Bkorotko03/ALTrainSeismo/ALProjNotes/AL ToDo.md

#### Generic
This is a todo list for the project. Please leave initials and such for completion or requests.
- [ ] get access to underneath redline SOON
- [x] order parts
- [x] Design the actual geophone, make sure the spec is good enough we can do 3 of them
- [ ] ~~figure out math for magnet movement vs coil voltage~~
- [ ] finalize code for signal processing on raspi
- [x] figure out how to take in analog voltage on arduino and output to sd card
- [ ] update parts list
- [ ] set concrete timelines
- [ ] oh yeah we should make our docs better and have code comments

### Making the geophones
- [ ] makes holes in the jars
- [ ] figure out how we're mounting these, level surfaces?
- [ ] mount spring and magnets on rods
- [ ] make coils
- [ ] figure out amplification!!

### arduinos
- [ ] how exactly are we attaching the coils to the arduino? pins are soldered oops
- [ ] best data conventions to make backend easy?
- [ ] how much preprocess can we afford to do on arduino?

### backend
- [ ] feasible to run on pi? do test run of no signal to see how heavy computation is
- [ ] write code to go from csv - panda - np arrays so we can make PSD estimate
- [ ] write code for figures
- [ ] make into interactive python script in terminal, want notebooks for dev only probably

#### Bennett

#### Cole

#### Danny

#### Jill
