Bkorotko03/ALTrainSeismo/ALProjNotes/DailyNotes.md

### 2/10/26
- Start development offline
- Can move to RF later if we feel like it
- We're going to try and make geophones, see link [here](https://www.embedded.com/geophone-with-arduino-r4/)
- Sent a basic parts list today to Bougie

### 4/2/26
- Glue op amps and arduino cases onto the jars
- Perform test run near red line
- Send email to transit
- Make PSD of mag run
- do a nomag run
- Make PSD of nomag run
