Bkorotko03/ALTrainSeismo/figureOut/260413_220258/avgEventPSDfs50.0.png

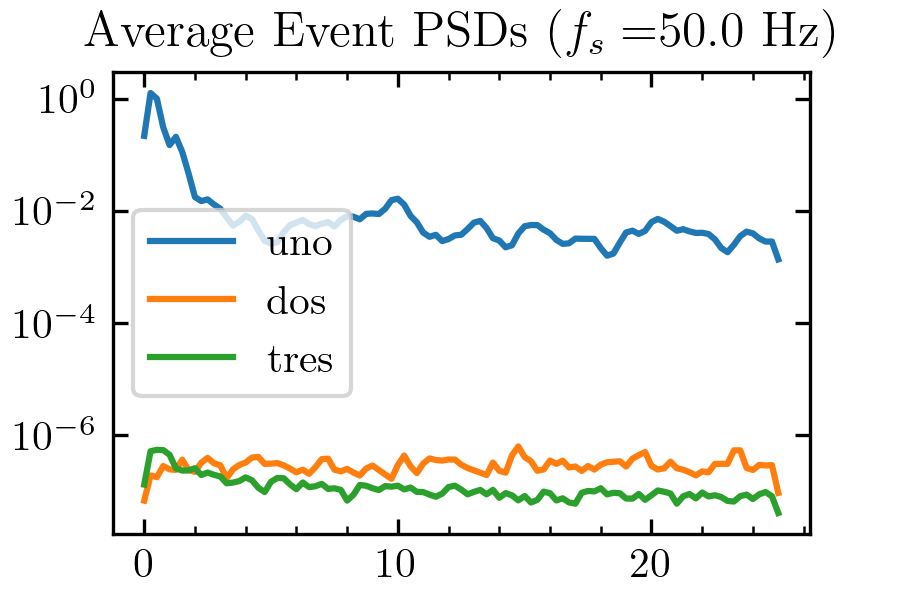
figureOut/260413_220258/avgEventPSDfs50.0.png
