Bkorotko03/ALTrainSeismo/figureOut/260413_221004/ampNoise.png

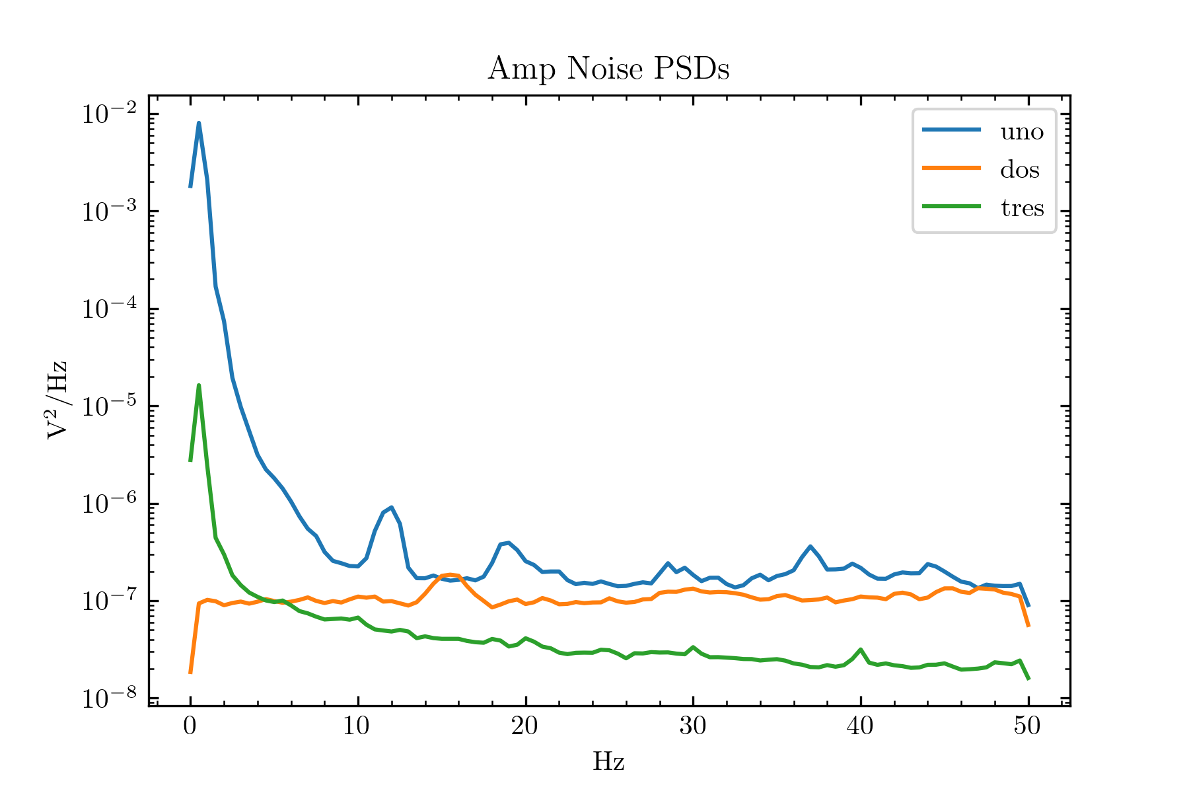
figureOut/260413_221004/ampNoise.png
