Bkorotko03/ALTrainSeismo/figureOut/260413_221004/avgEventPSDfs100.png

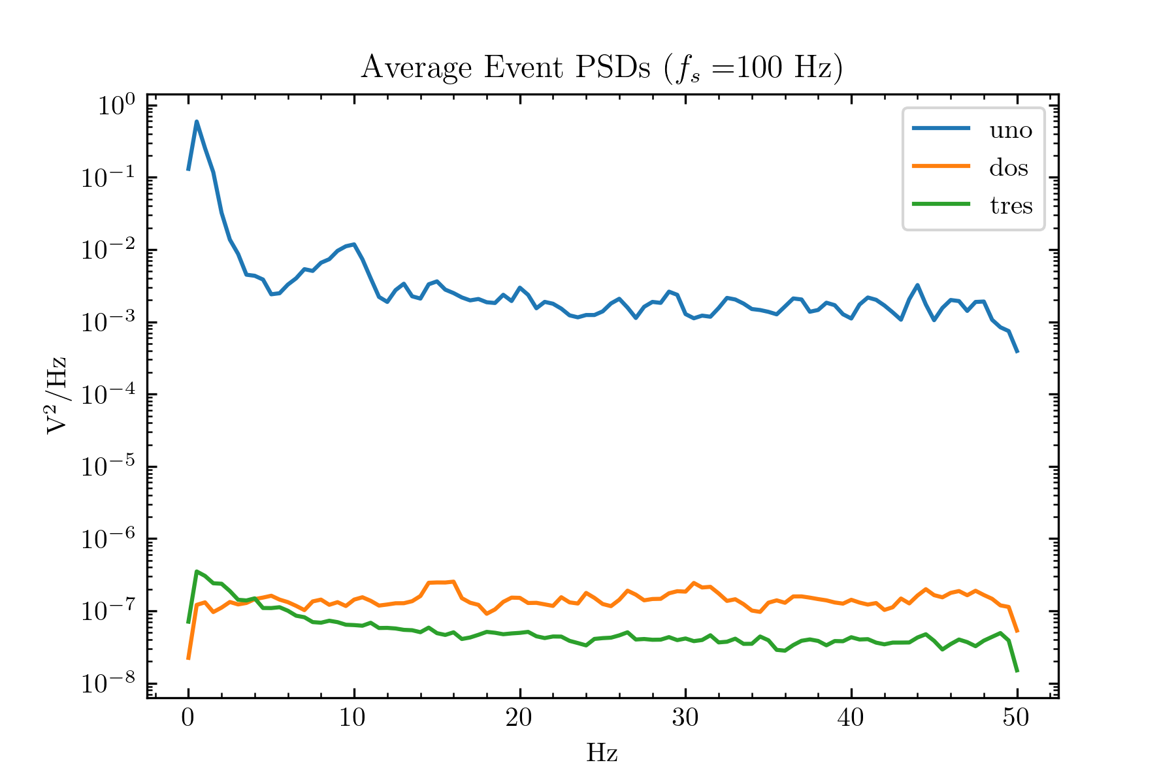
figureOut/260413_221004/avgEventPSDfs100.png
