Bkorotko03/ALTrainSeismo/figureOut/260413_221004/bkgdOverAmp.png

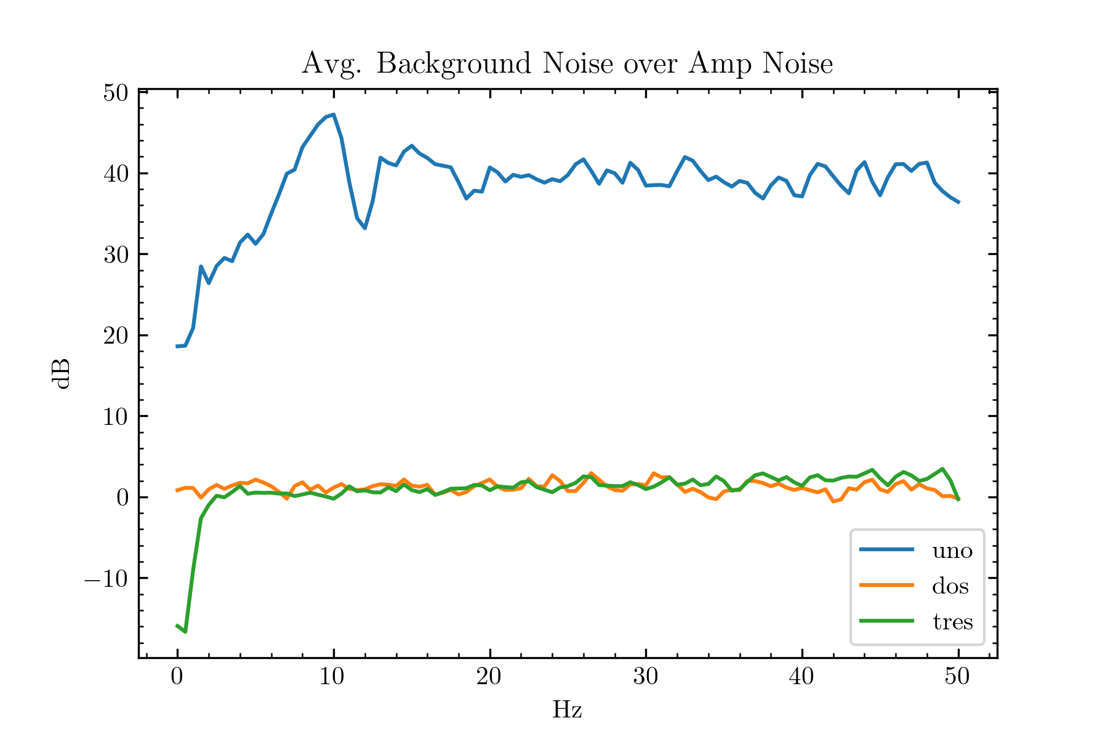
figureOut/260413_221004/bkgdOverAmp.png
