Bkorotko03/ALTrainSeismo/figureOut/260413_221004/dosEventVolt.png

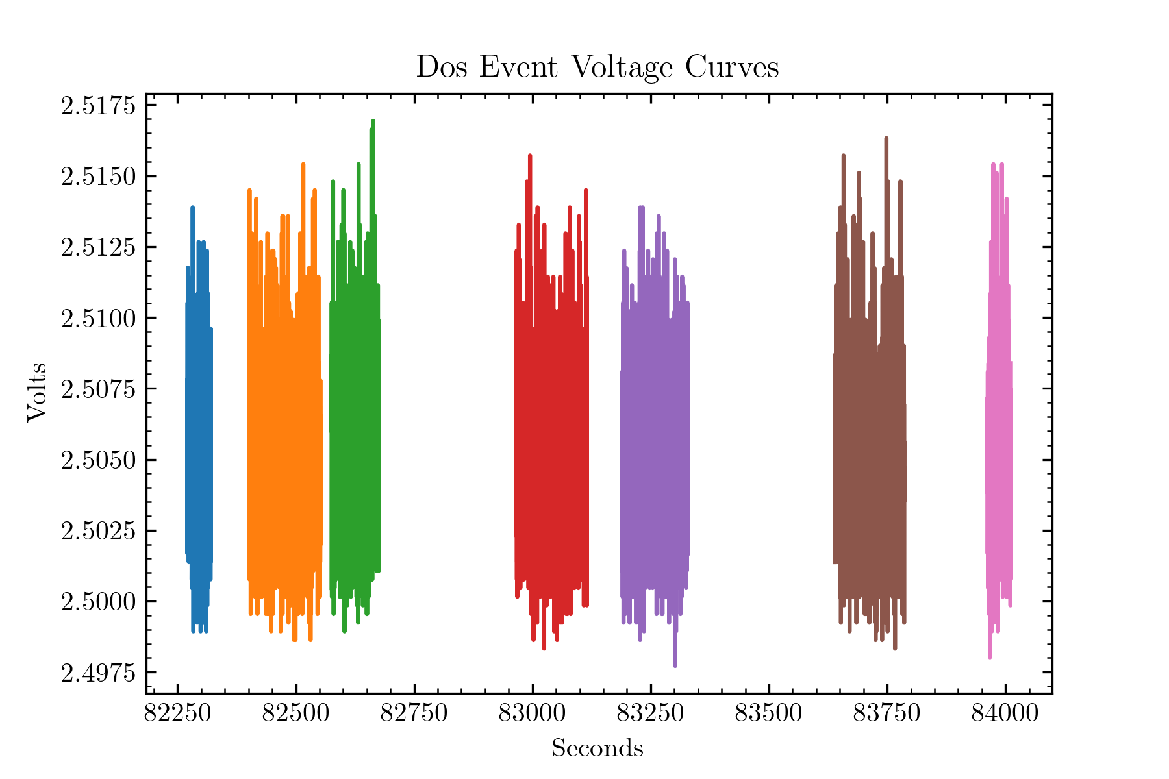
figureOut/260413_221004/dosEventVolt.png
