Bkorotko03/ALTrainSeismo/figureOut/260413_221004/dosNoiseVolt.png

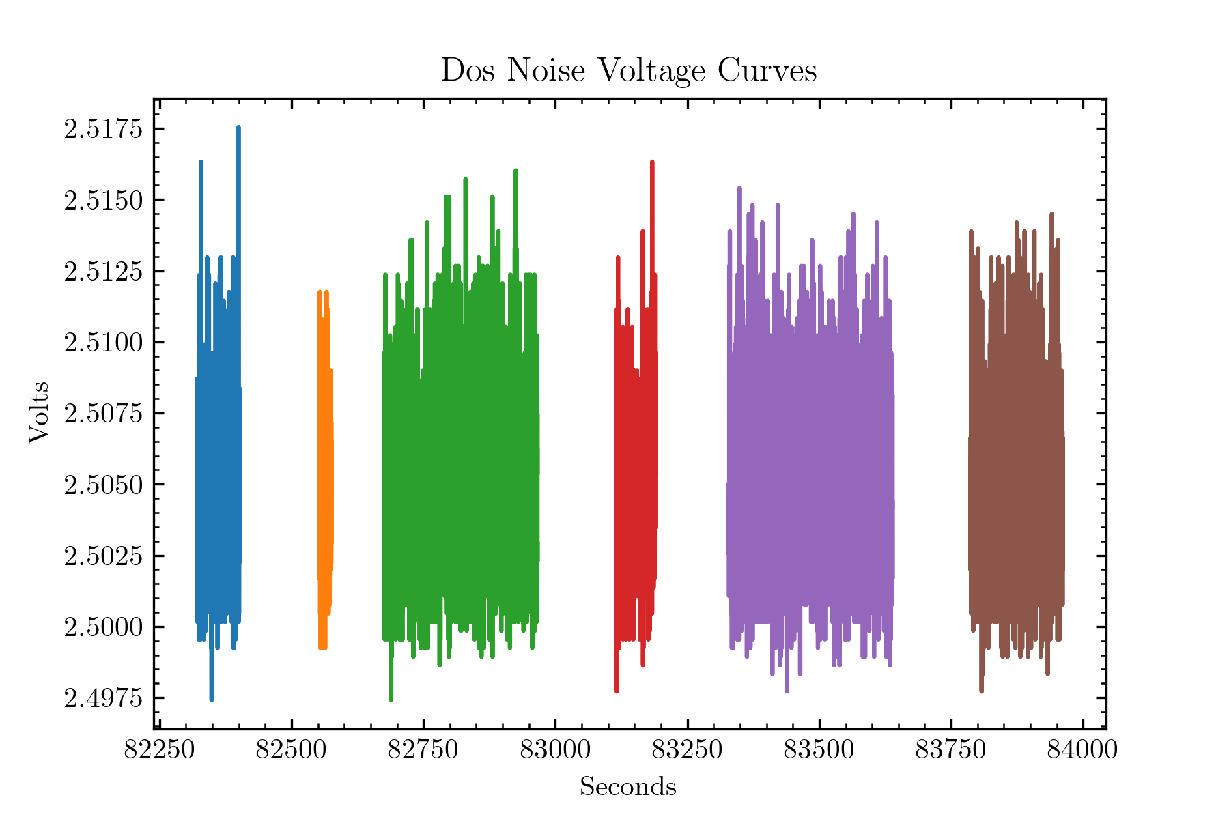
figureOut/260413_221004/dosNoiseVolt.png
