Bkorotko03/ALTrainSeismo/figureOut/260413_221004/rawSignal.png

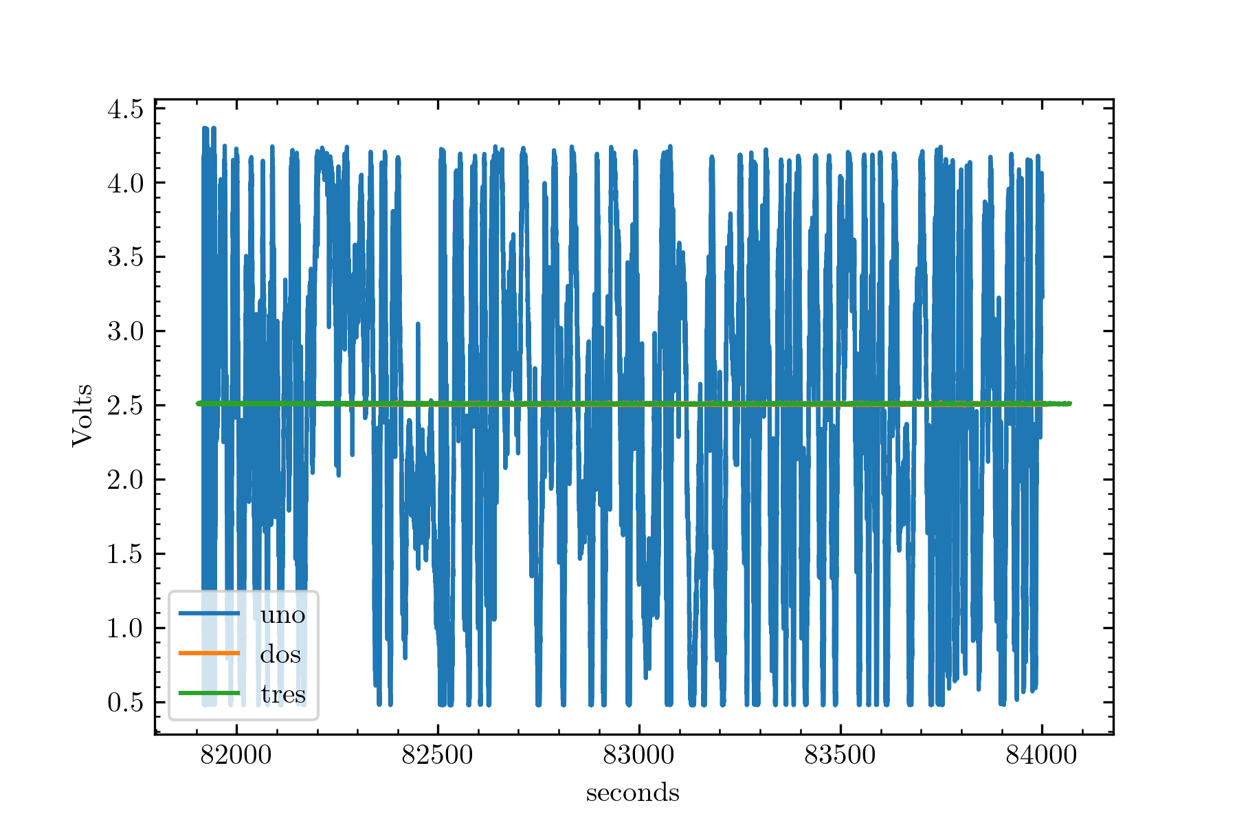
figureOut/260413_221004/rawSignal.png
