Bkorotko03/ALTrainSeismo/figureOut/260413_221004/trainOverBkgd.png

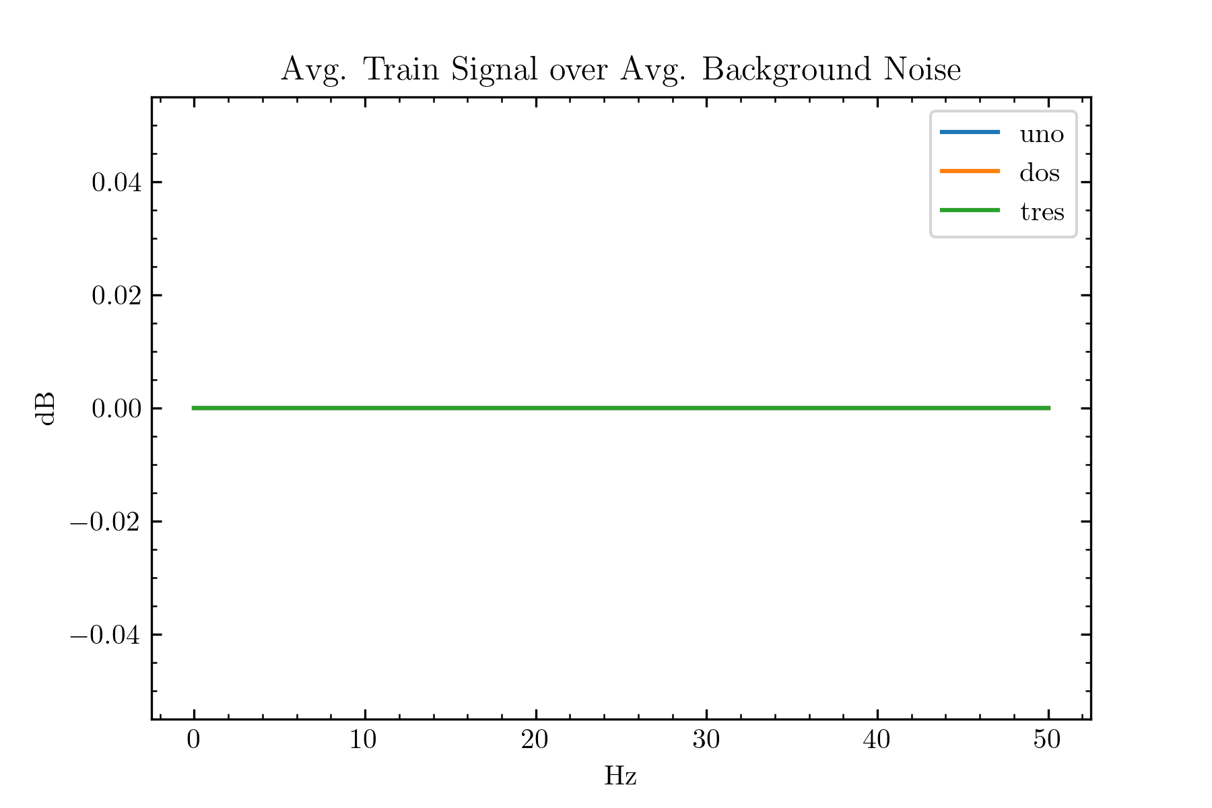
figureOut/260413_221004/trainOverBkgd.png
