Bkorotko03/ALTrainSeismo/figureOut/260413_221004/tresEventVolt.png

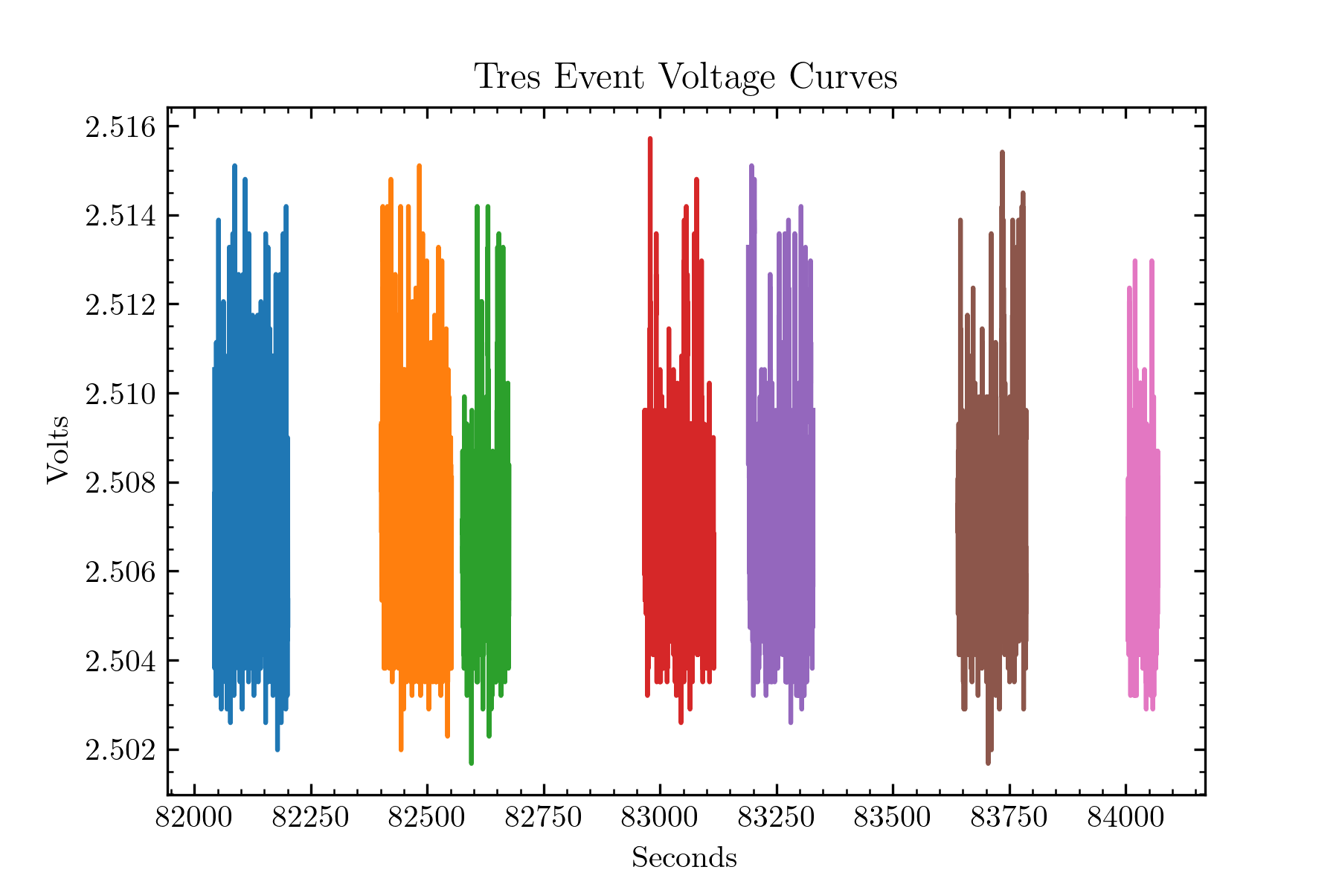
figureOut/260413_221004/tresEventVolt.png
