Bkorotko03/ALTrainSeismo/figureOut/260413_221004/tresNoiseVolt.png

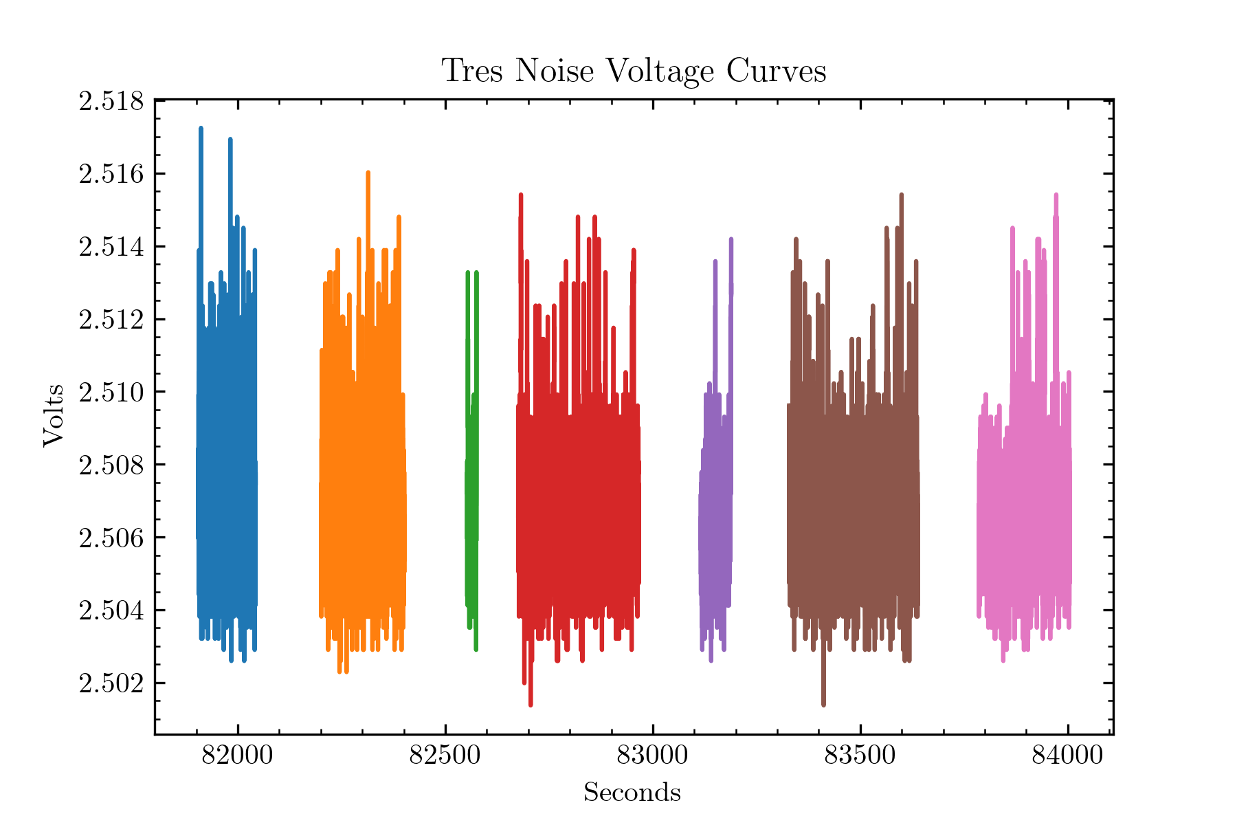
figureOut/260413_221004/tresNoiseVolt.png
