Bkorotko03/ALTrainSeismo/figureOut/260413_221004/unoEventVolt.png

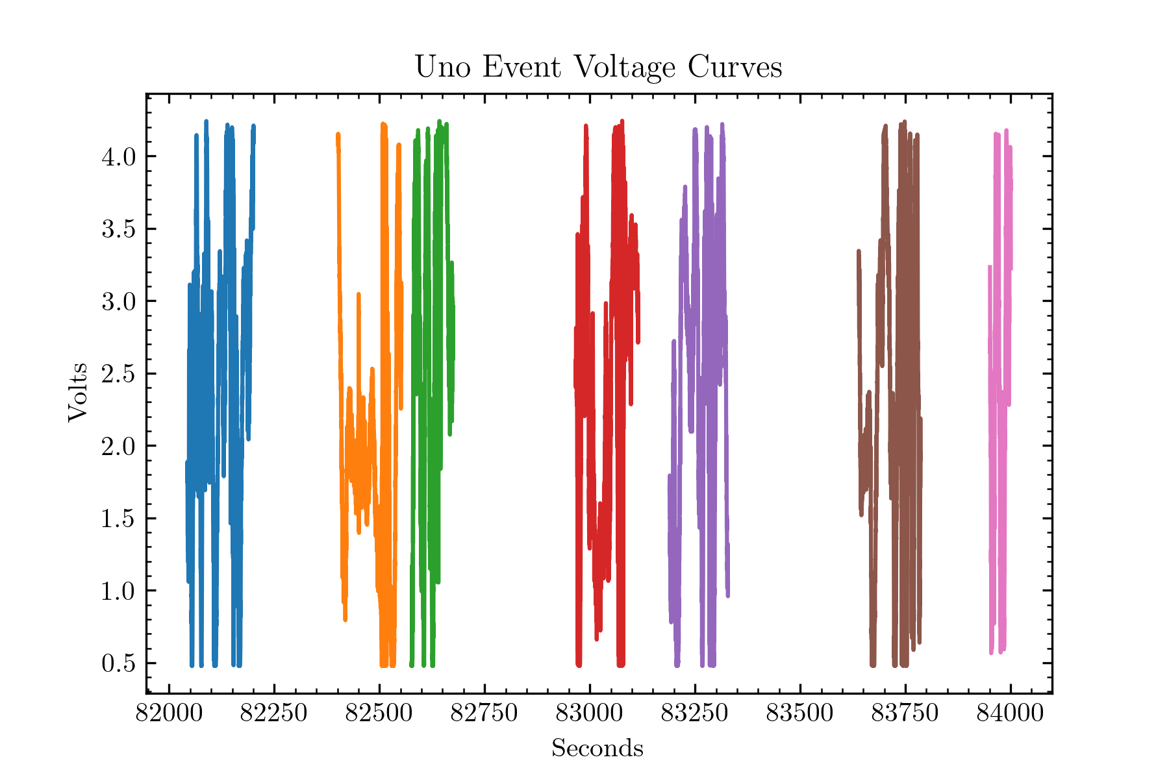
figureOut/260413_221004/unoEventVolt.png
