Bkorotko03/ALTrainSeismo/figureOut/260413_221004/unoNoiseVolt.png

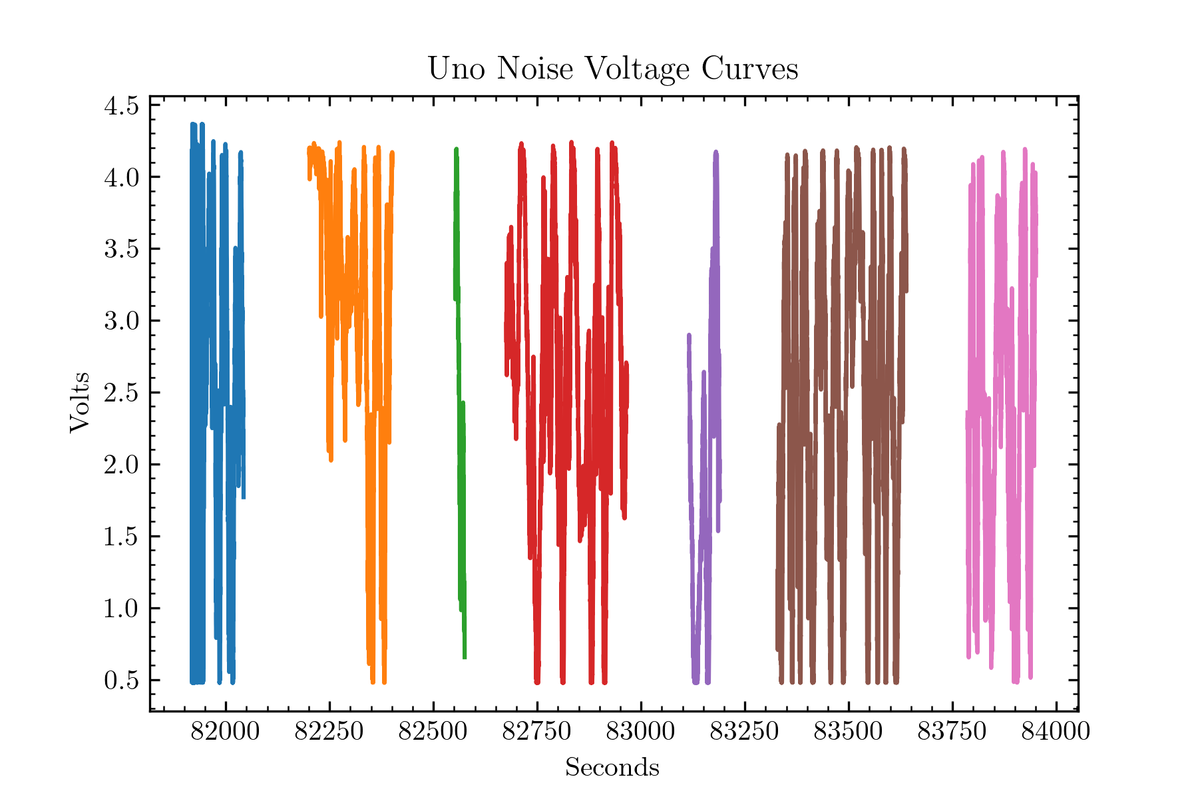
figureOut/260413_221004/unoNoiseVolt.png
