Bkorotko03/ALTrainSeismo/figureOut/260418_205335/ampNoisefs100.png

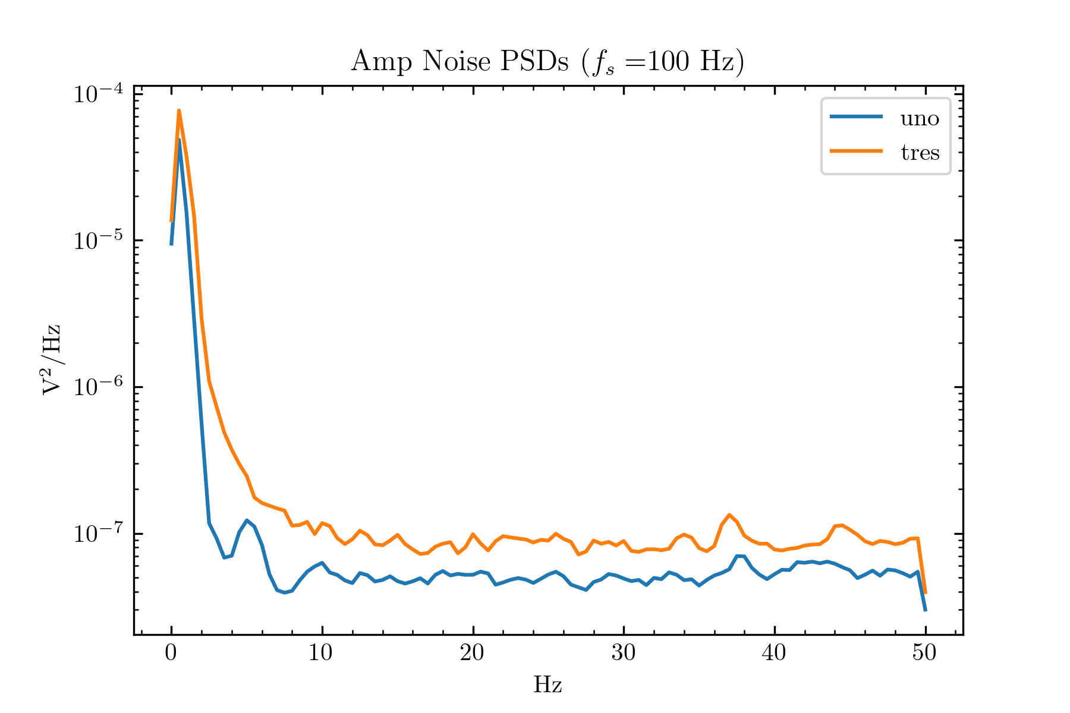
figureOut/260418_205335/ampNoisefs100.png
