Bkorotko03/ALTrainSeismo/figureOut/260418_205335/avgEventPSDfs100.png

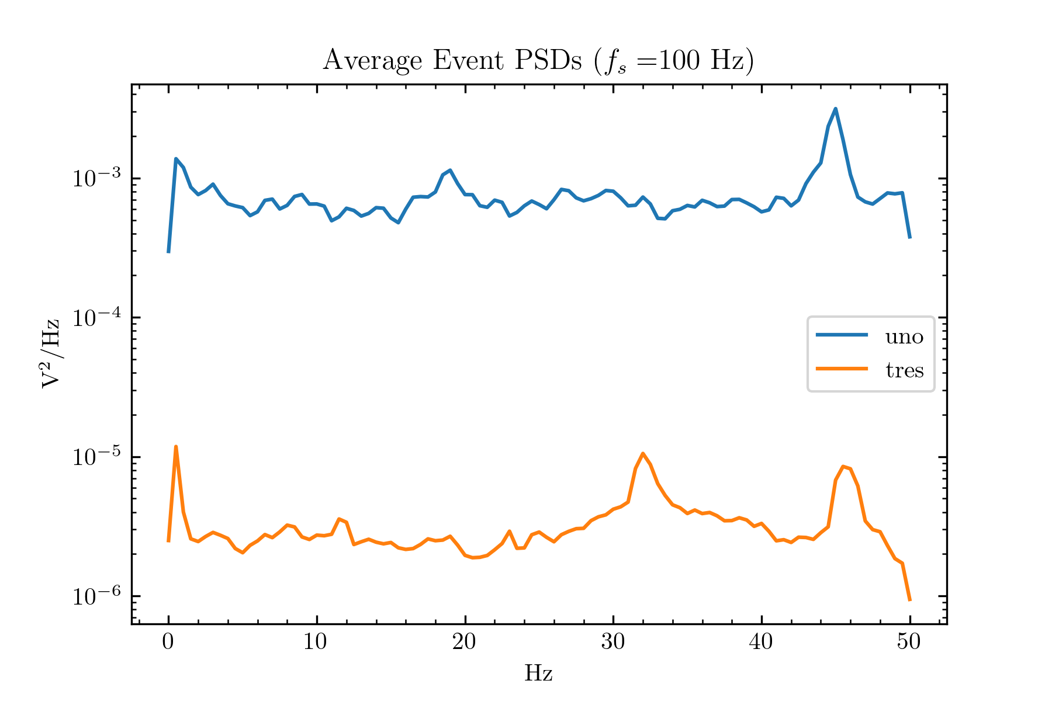
figureOut/260418_205335/avgEventPSDfs100.png
