Bkorotko03/ALTrainSeismo/figureOut/260418_205335/avgNoisePSDfs100.png

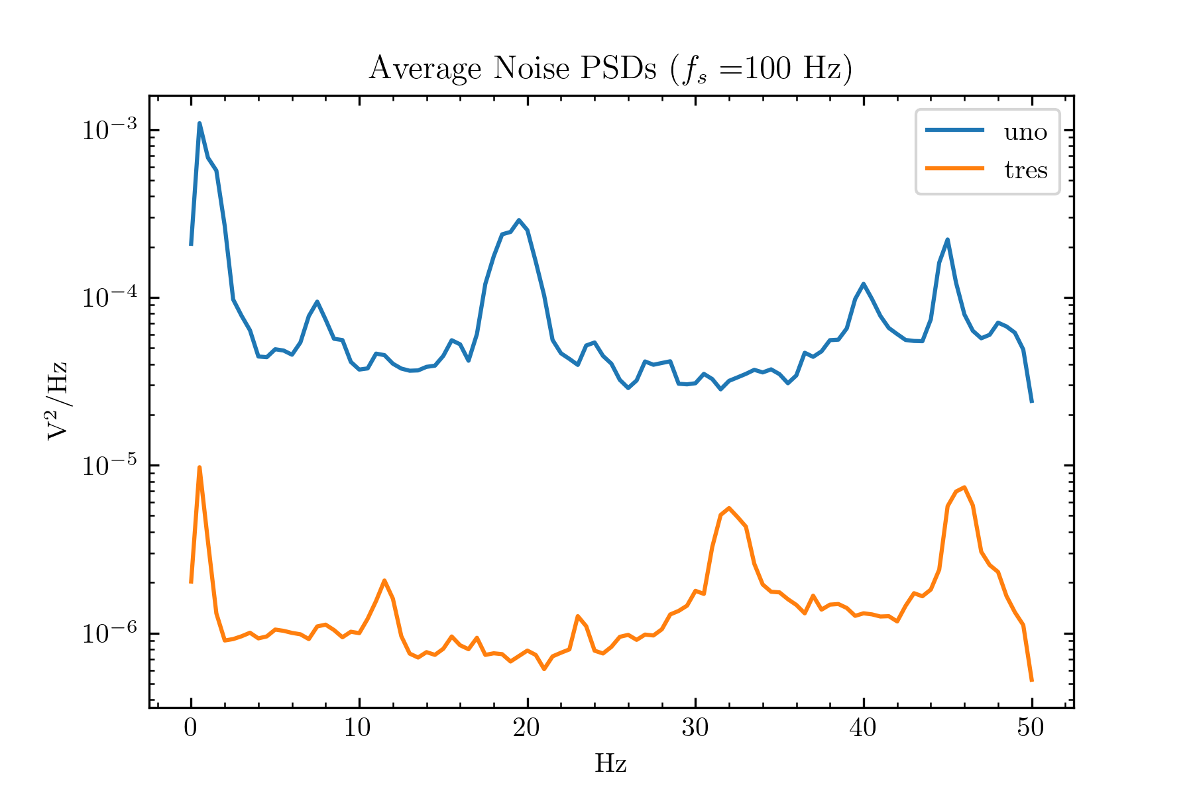
figureOut/260418_205335/avgNoisePSDfs100.png
