Bkorotko03/ALTrainSeismo/figureOut/260418_205335/bkgdOverAmpfs100.png

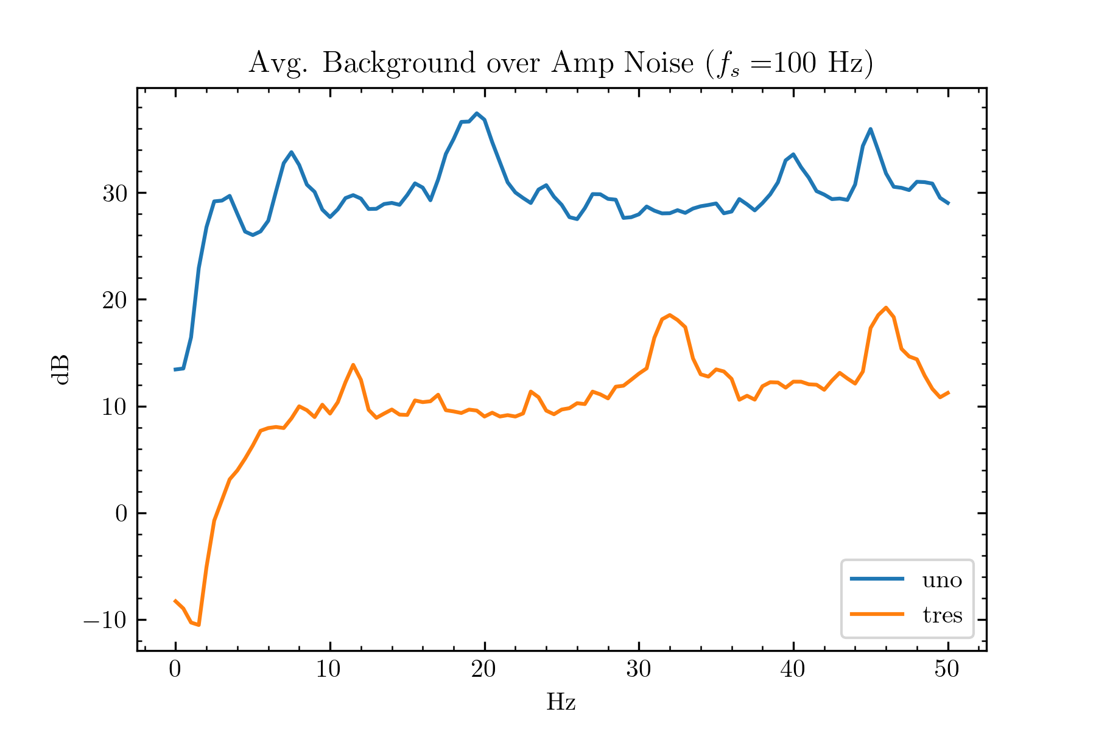
figureOut/260418_205335/bkgdOverAmpfs100.png
