Bkorotko03/ALTrainSeismo/figureOut/260418_205335/rawSignal.png

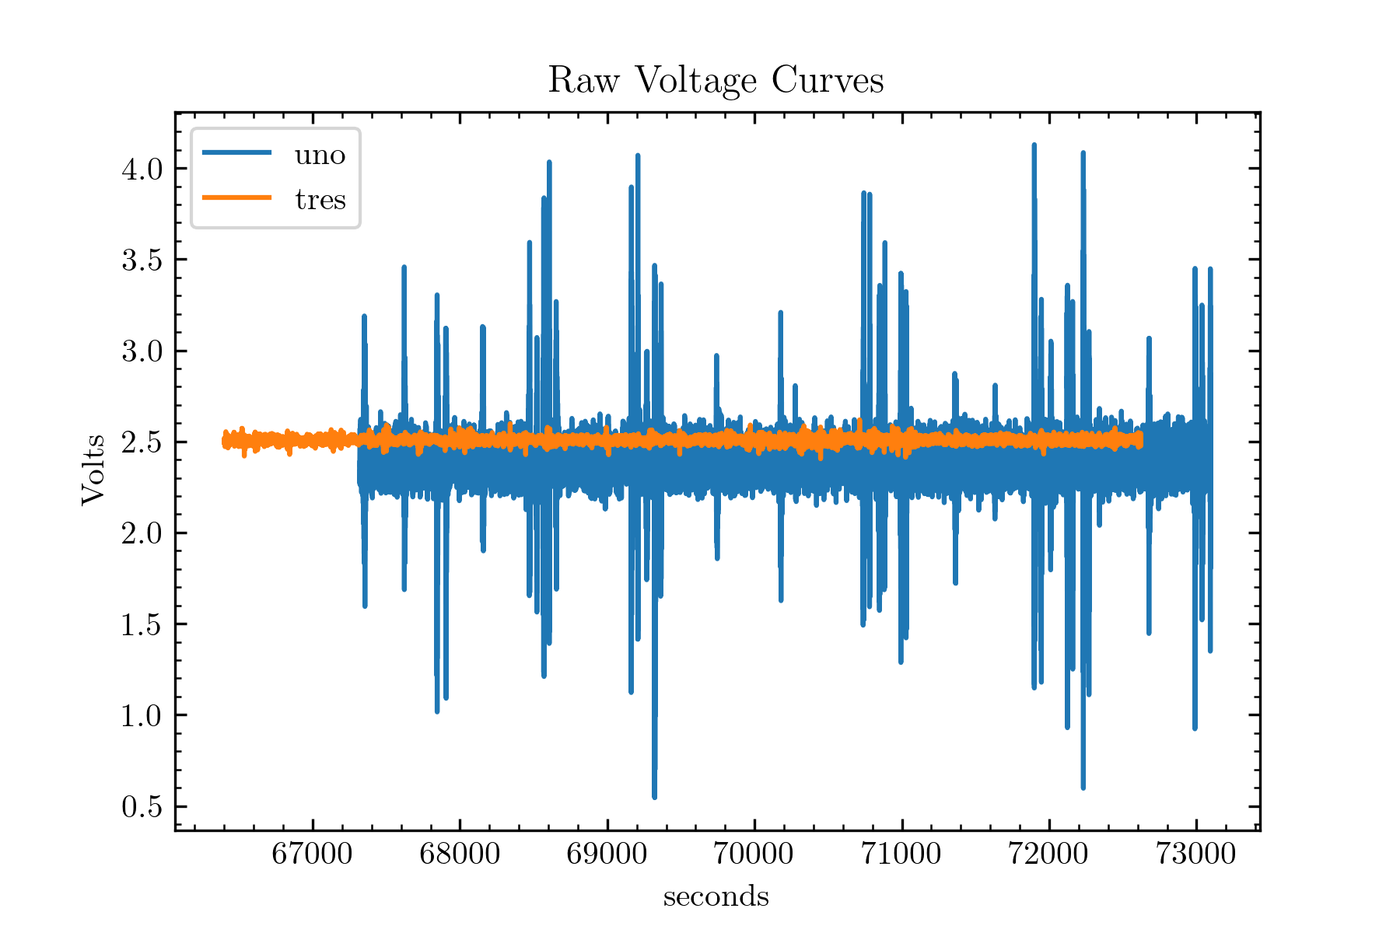
figureOut/260418_205335/rawSignal.png
