Bkorotko03/ALTrainSeismo/figureOut/260418_205335/SNRvsWindow.png

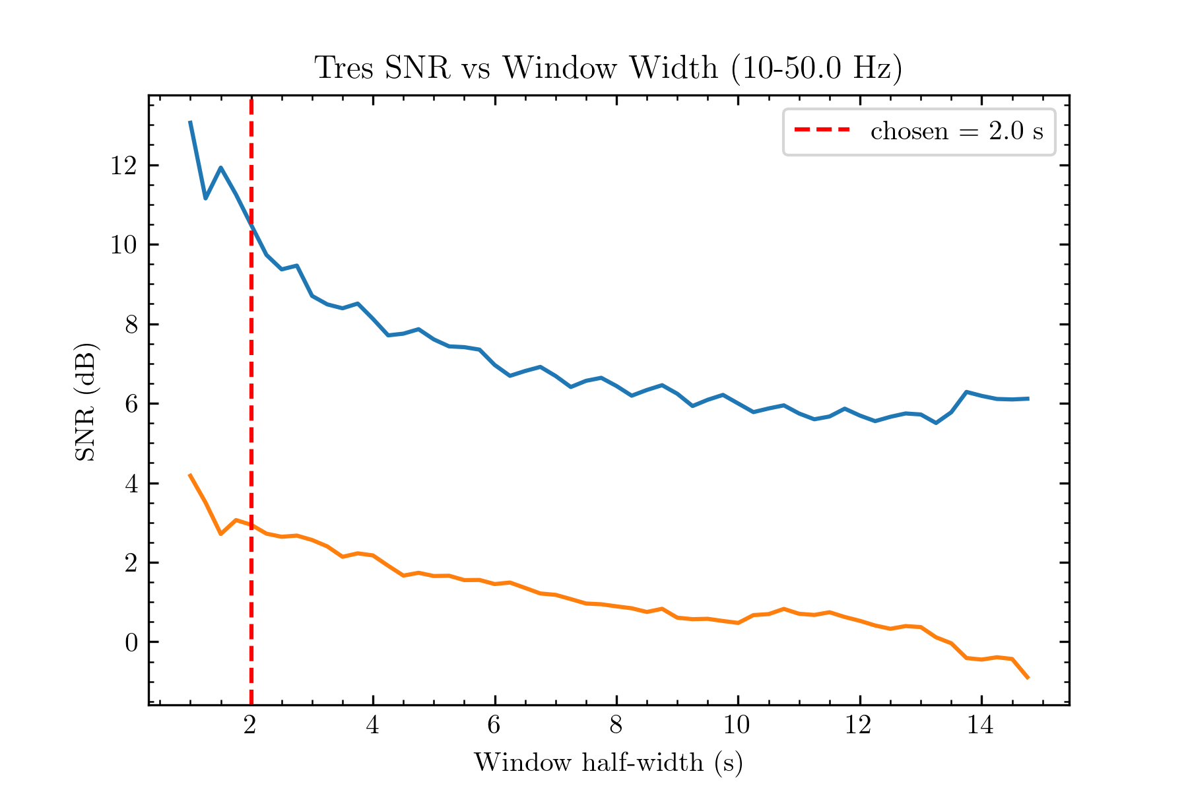
figureOut/260418_205335/SNRvsWindow.png
