Bkorotko03/ALTrainSeismo/figureOut/260418_205335/tresEventVolt.png

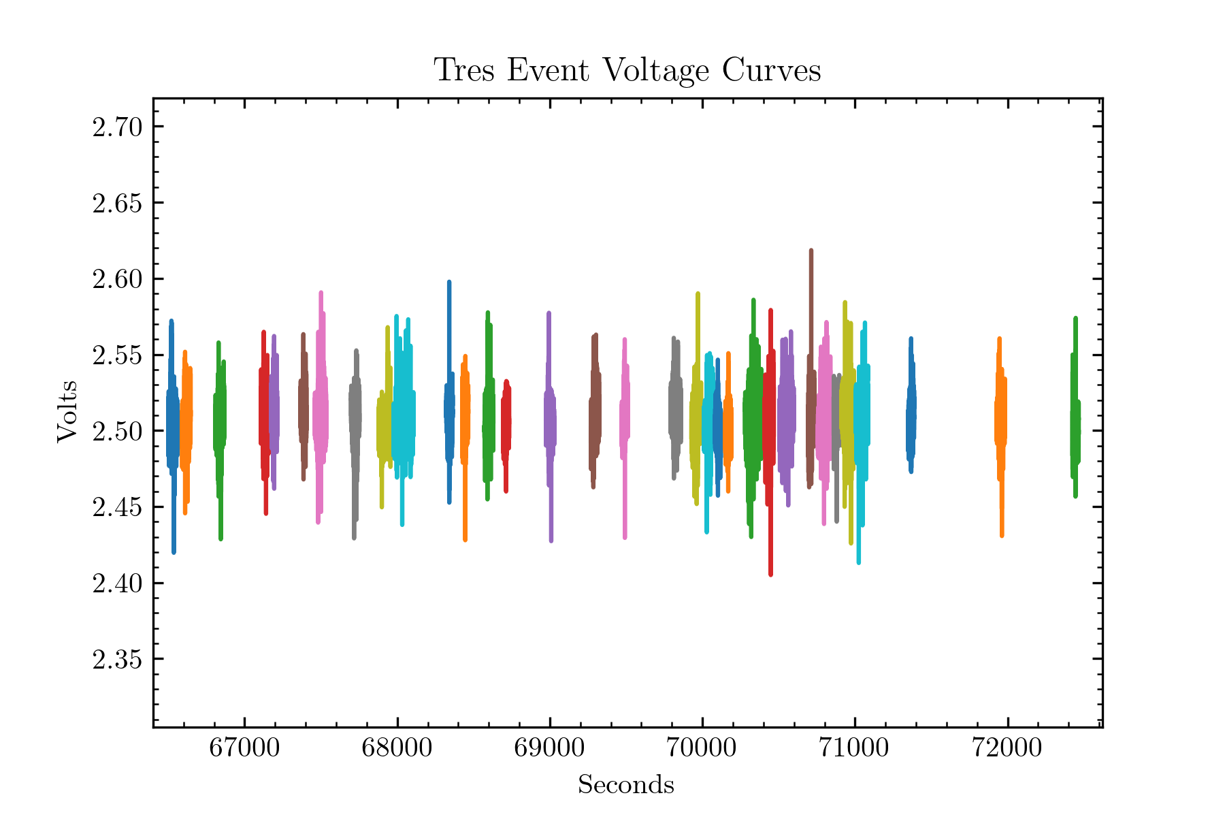
figureOut/260418_205335/tresEventVolt.png
