Bkorotko03/ALTrainSeismo/figureOut/260418_205335/tresNoiseVolt.png

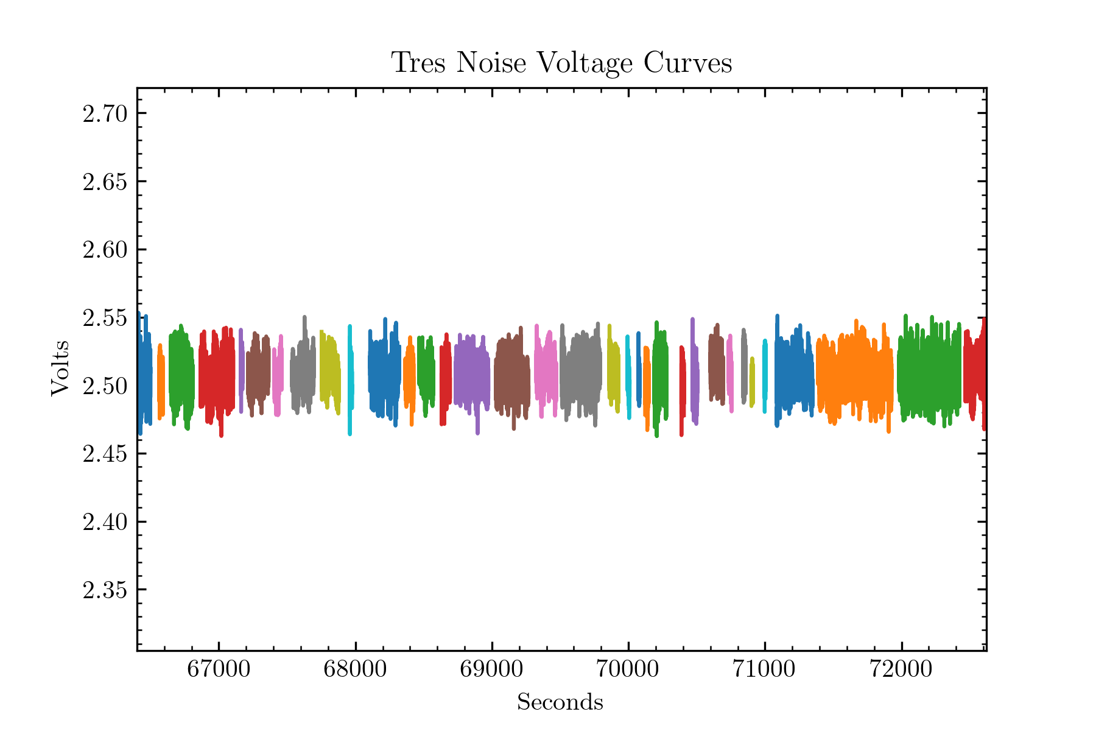
figureOut/260418_205335/tresNoiseVolt.png
