Bkorotko03/ALTrainSeismo/figureOut/260418_205335/unoEventVolt.png

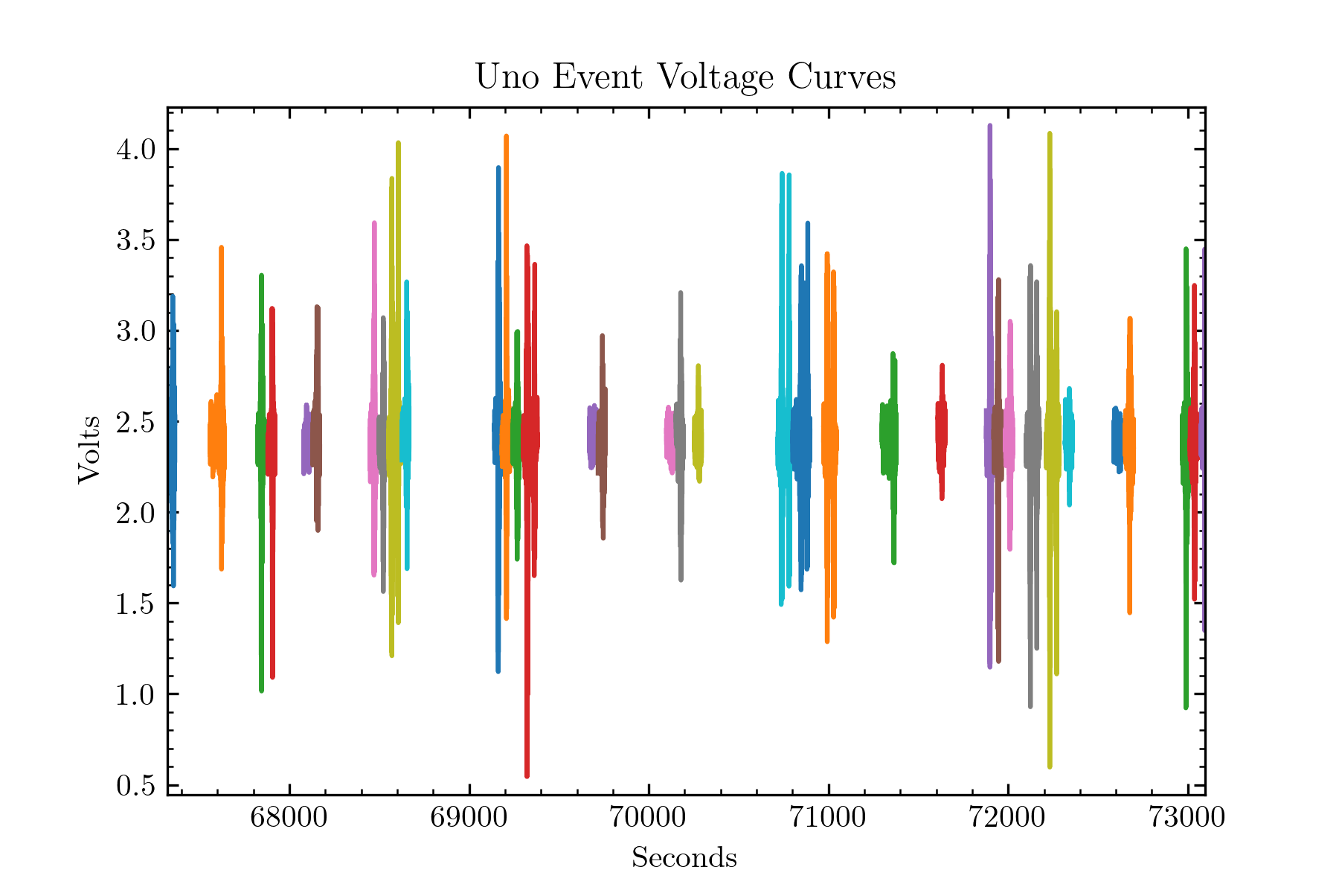
figureOut/260418_205335/unoEventVolt.png
