Bkorotko03/ALTrainSeismo/figureOut/260418_205335/unoNoiseVolt.png

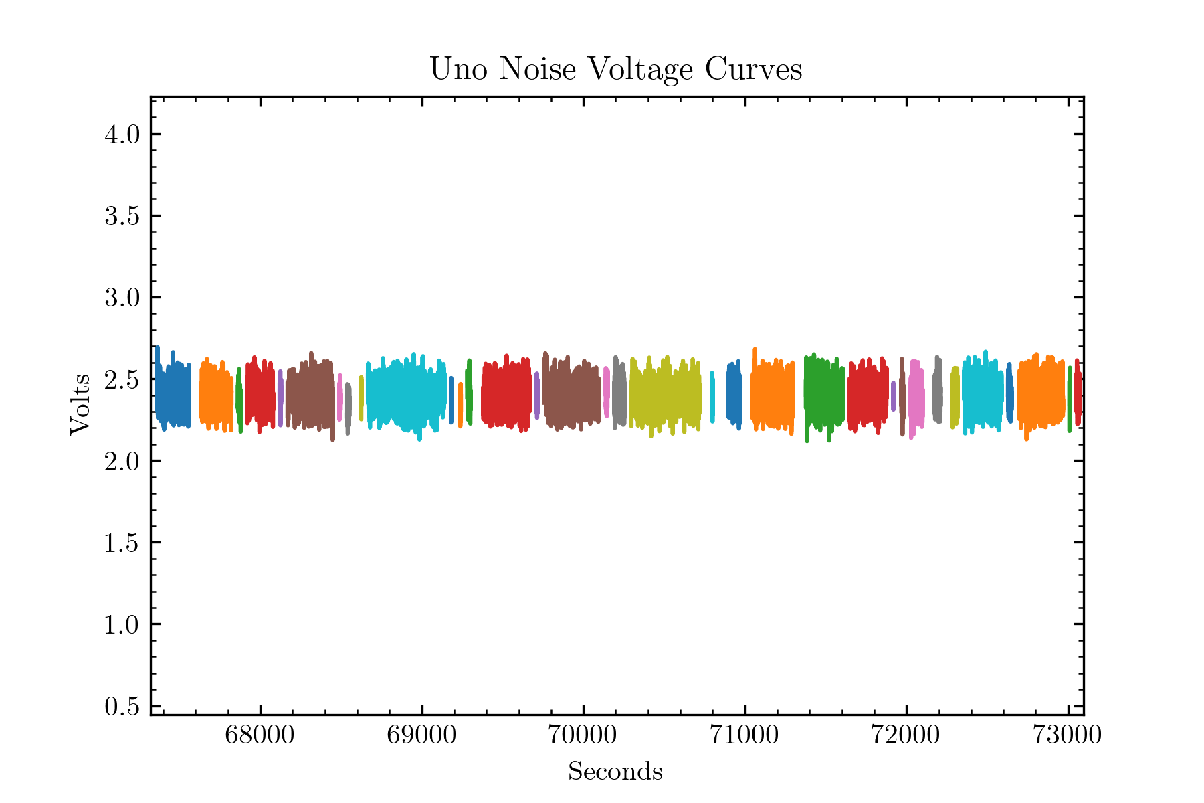
figureOut/260418_205335/unoNoiseVolt.png
