Bkorotko03/ALTrainSeismo/figureOut/conc3StatWork/tresSNRvsWindow.png

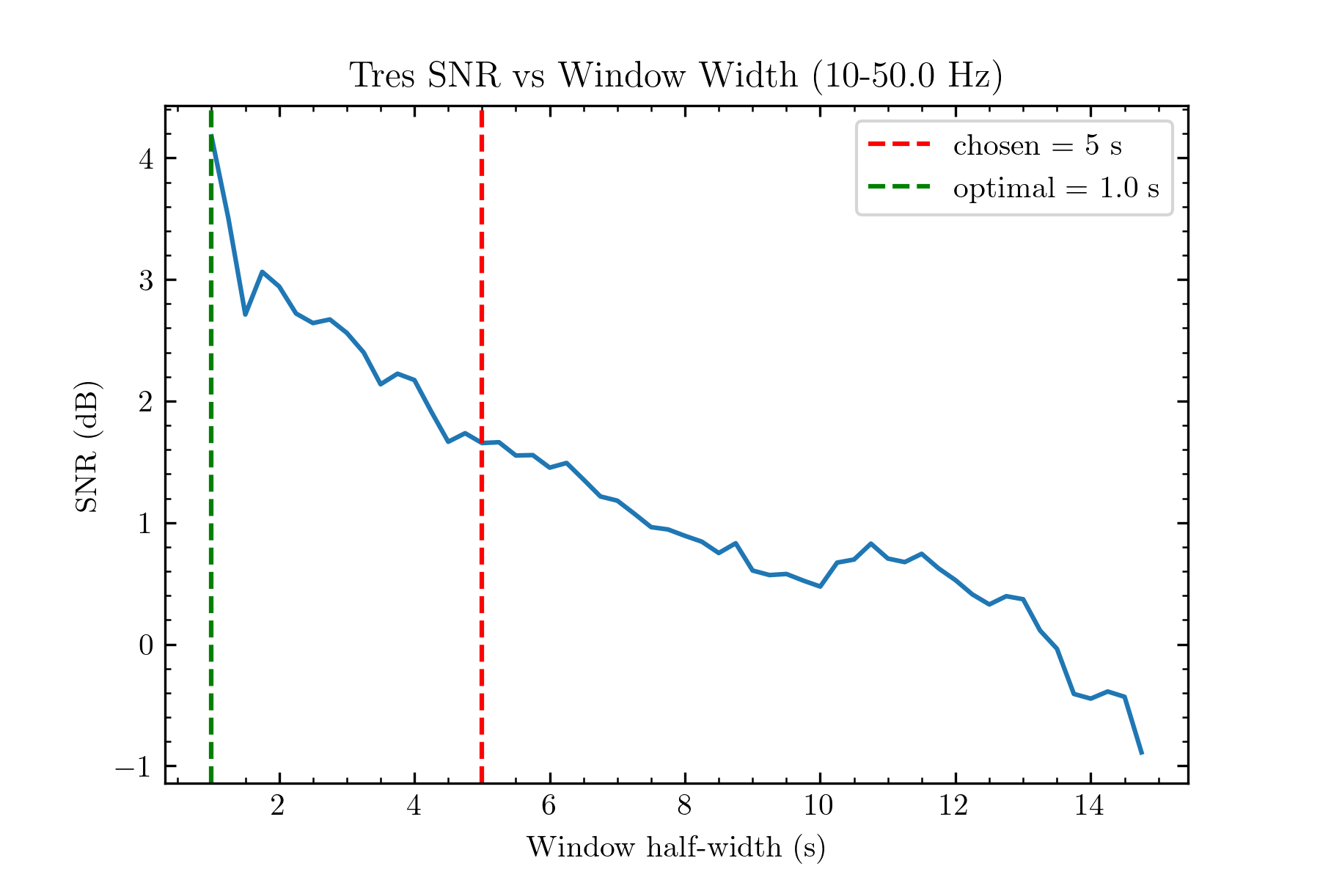
figureOut/conc3StatWork/tresSNRvsWindow.png
