Bkorotko03/ALTrainSeismo/figureOut/conc3StatWork/unoSNRvsWindow.png

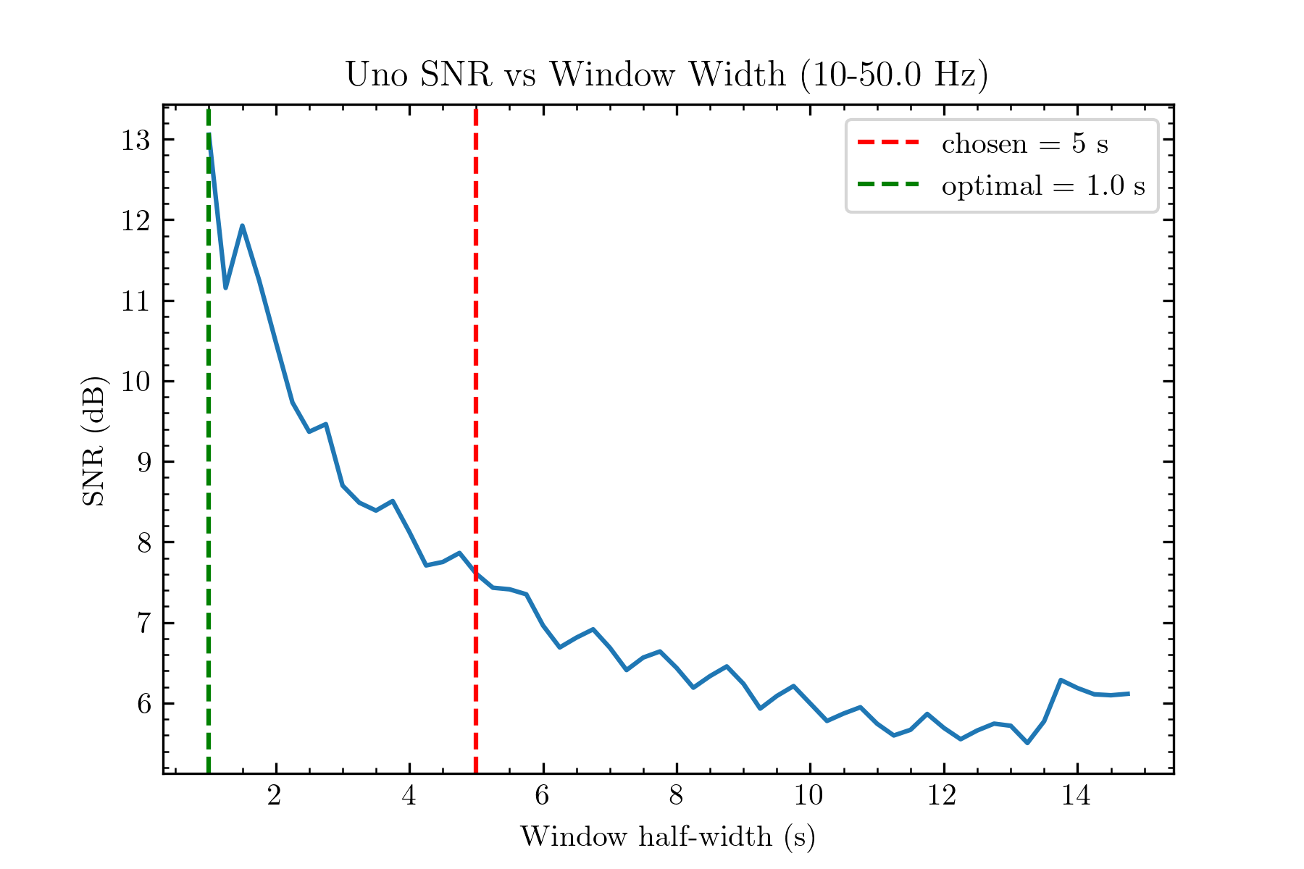
figureOut/conc3StatWork/unoSNRvsWindow.png
