Bkorotko03/ALTrainSeismo/figureOut/figFixed/avgEventPSDfs100.png

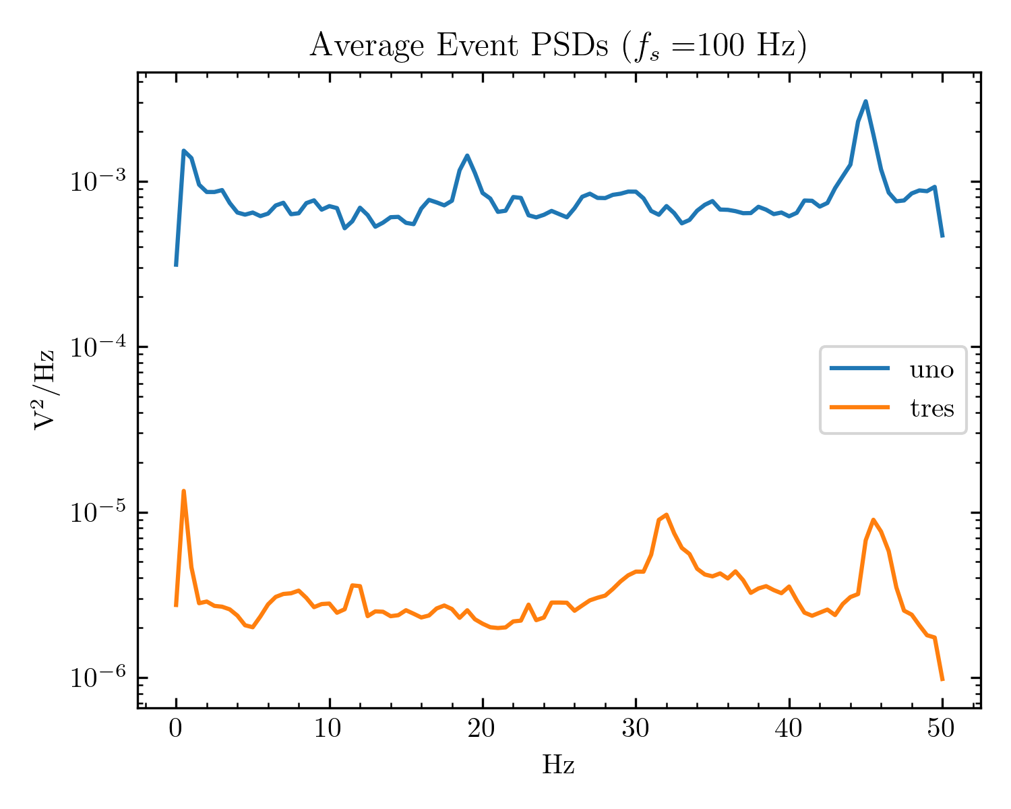
figureOut/figFixed/avgEventPSDfs100.png
