Bkorotko03/ALTrainSeismo/figureOut/figFixed/avgNoisePSDfs100.png

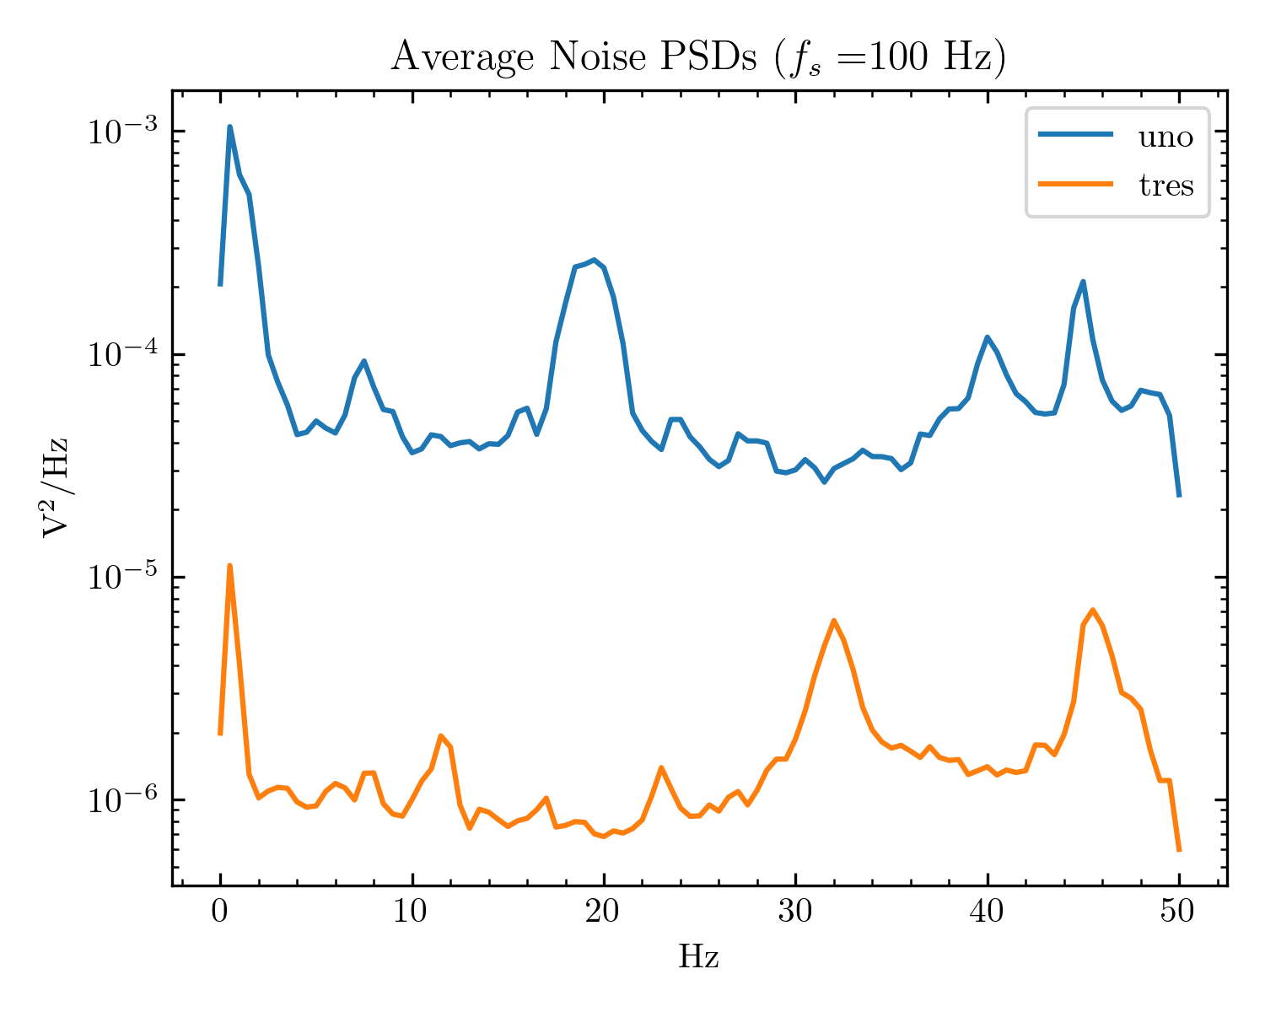
figureOut/figFixed/avgNoisePSDfs100.png
