Bkorotko03/ALTrainSeismo/figureOut/figFixed/bkgdOverAmpfs100.png

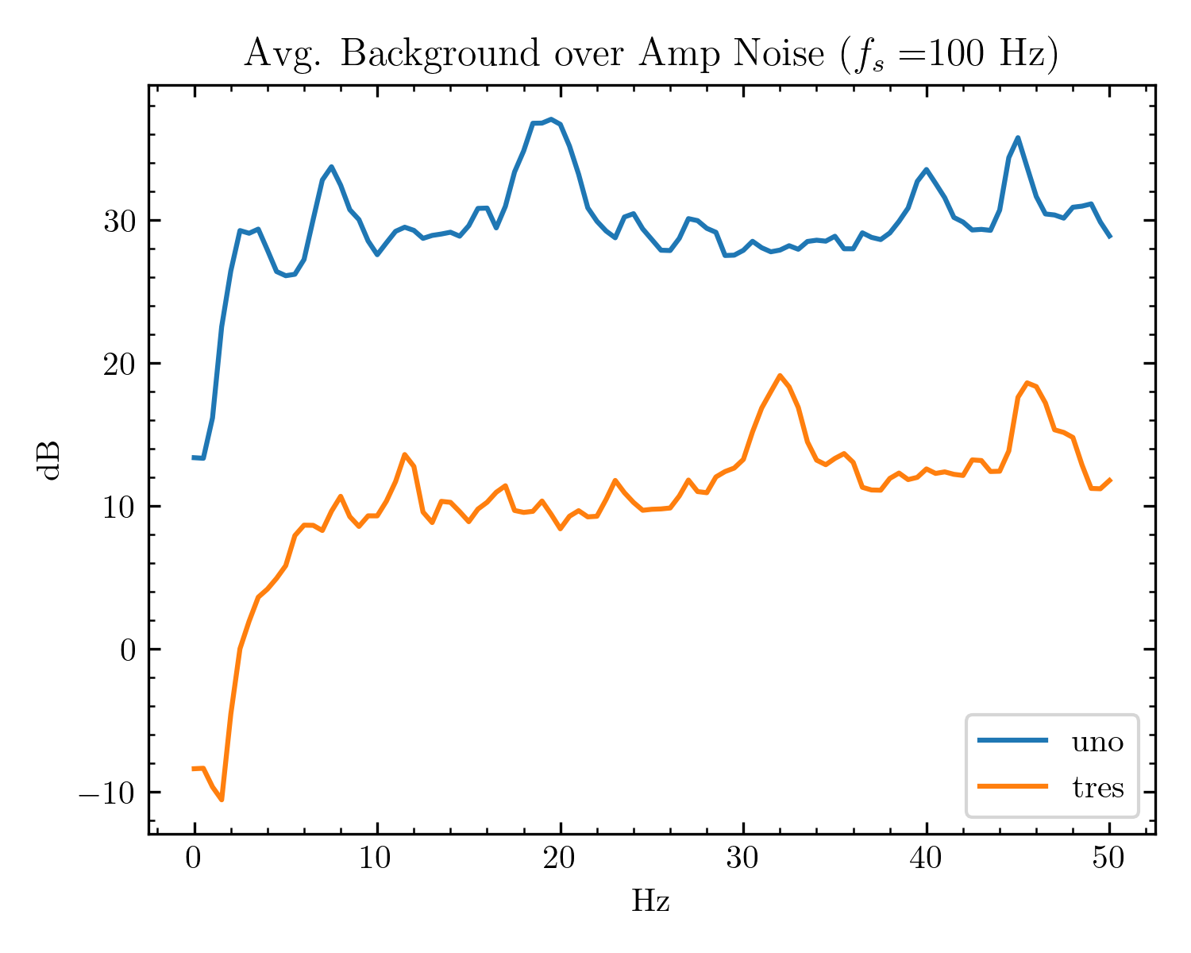
figureOut/figFixed/bkgdOverAmpfs100.png
