Bkorotko03/ALTrainSeismo/figureOut/figFixed/rawSignal.png

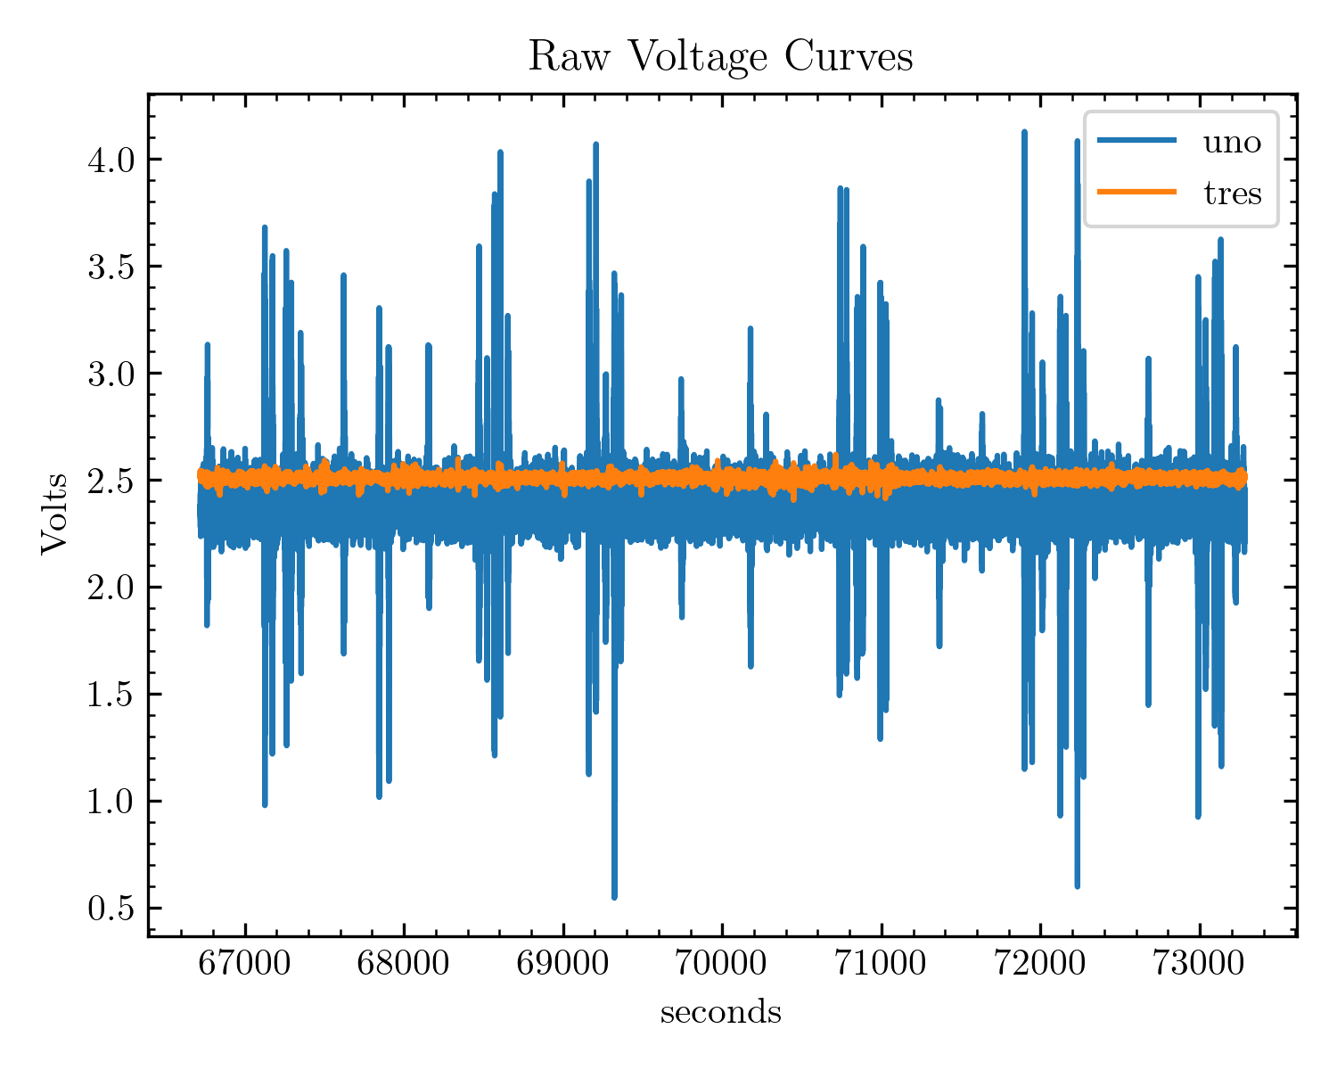
figureOut/figFixed/rawSignal.png
