Bkorotko03/ALTrainSeismo/figureOut/figFixed/SNRvsWindow.png

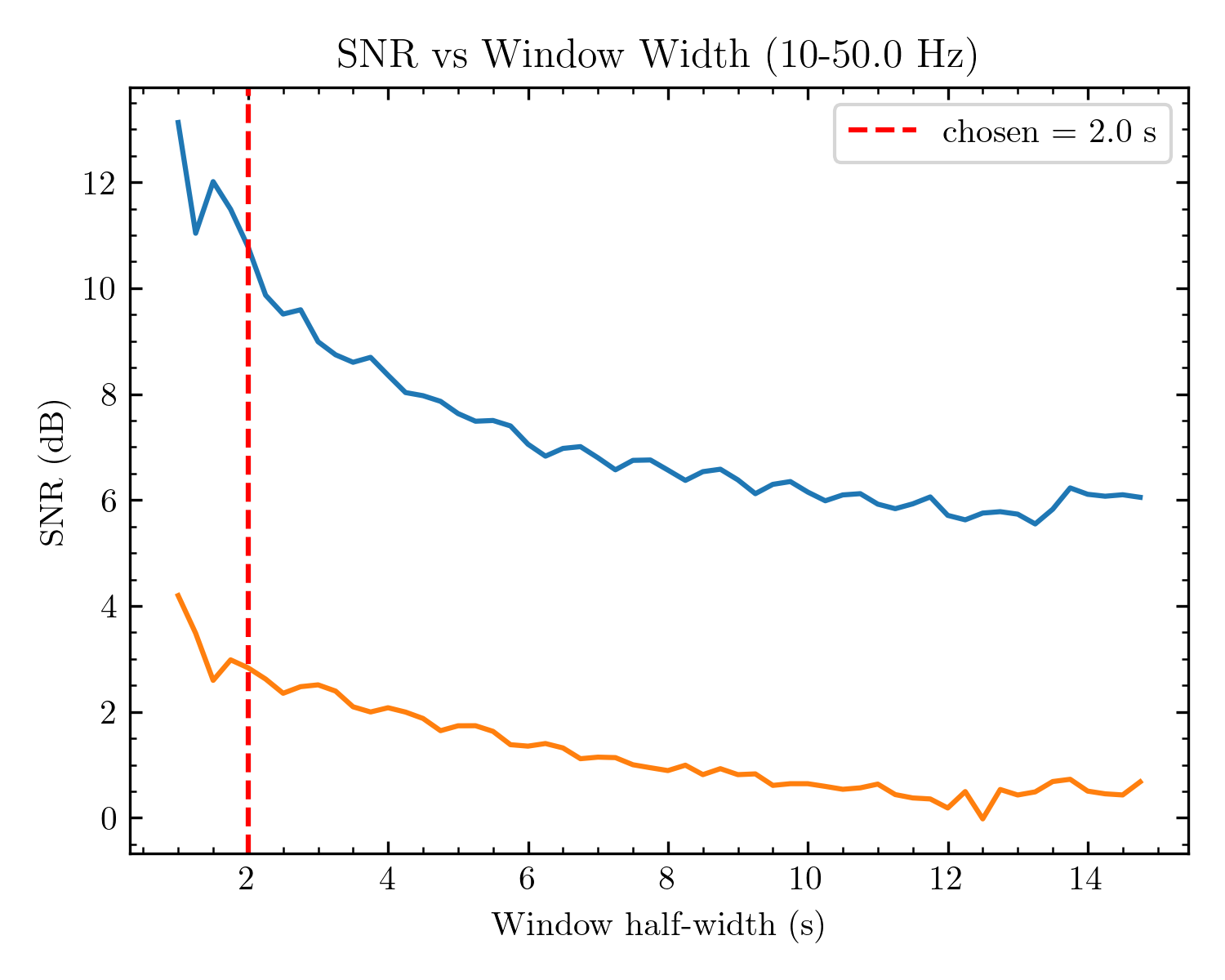
figureOut/figFixed/SNRvsWindow.png
