Bkorotko03/ALTrainSeismo/figureOut/figFixed/trainOverBkgdfs100.png

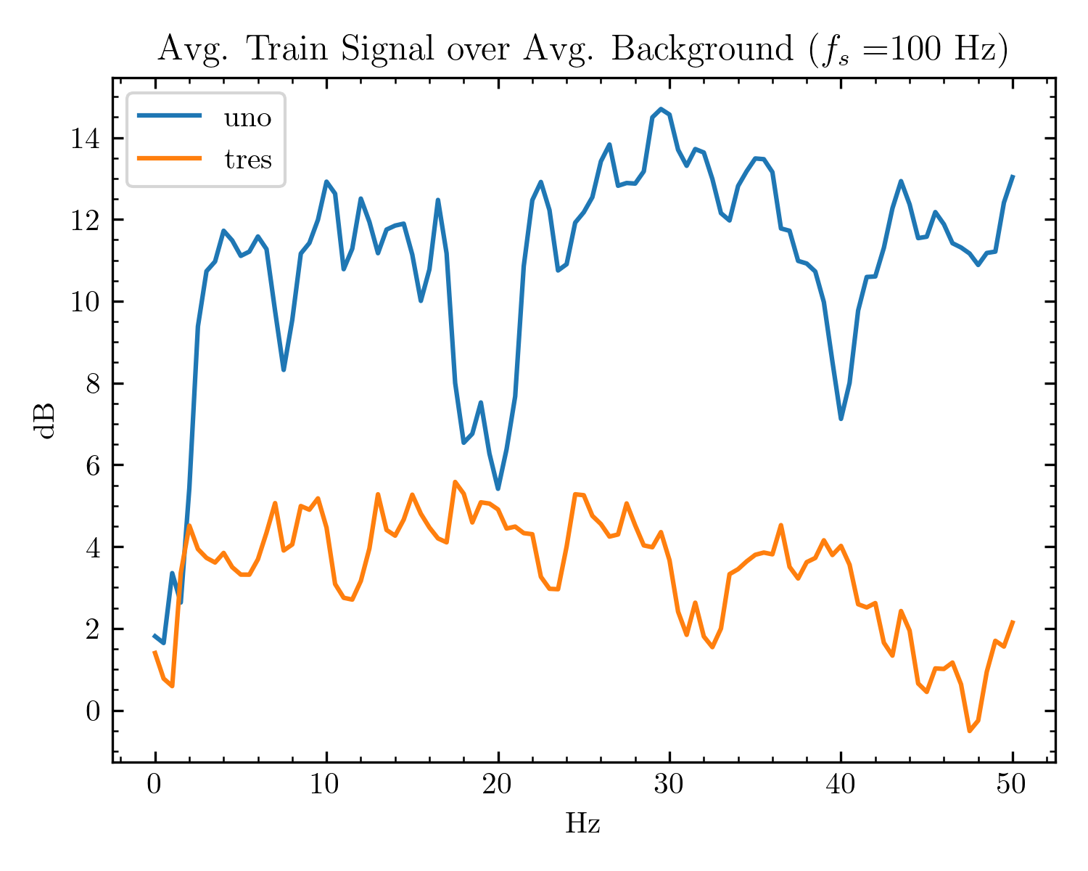
figureOut/figFixed/trainOverBkgdfs100.png
