Bkorotko03/ALTrainSeismo/figureOut/figFixed/tresEventVolt.png

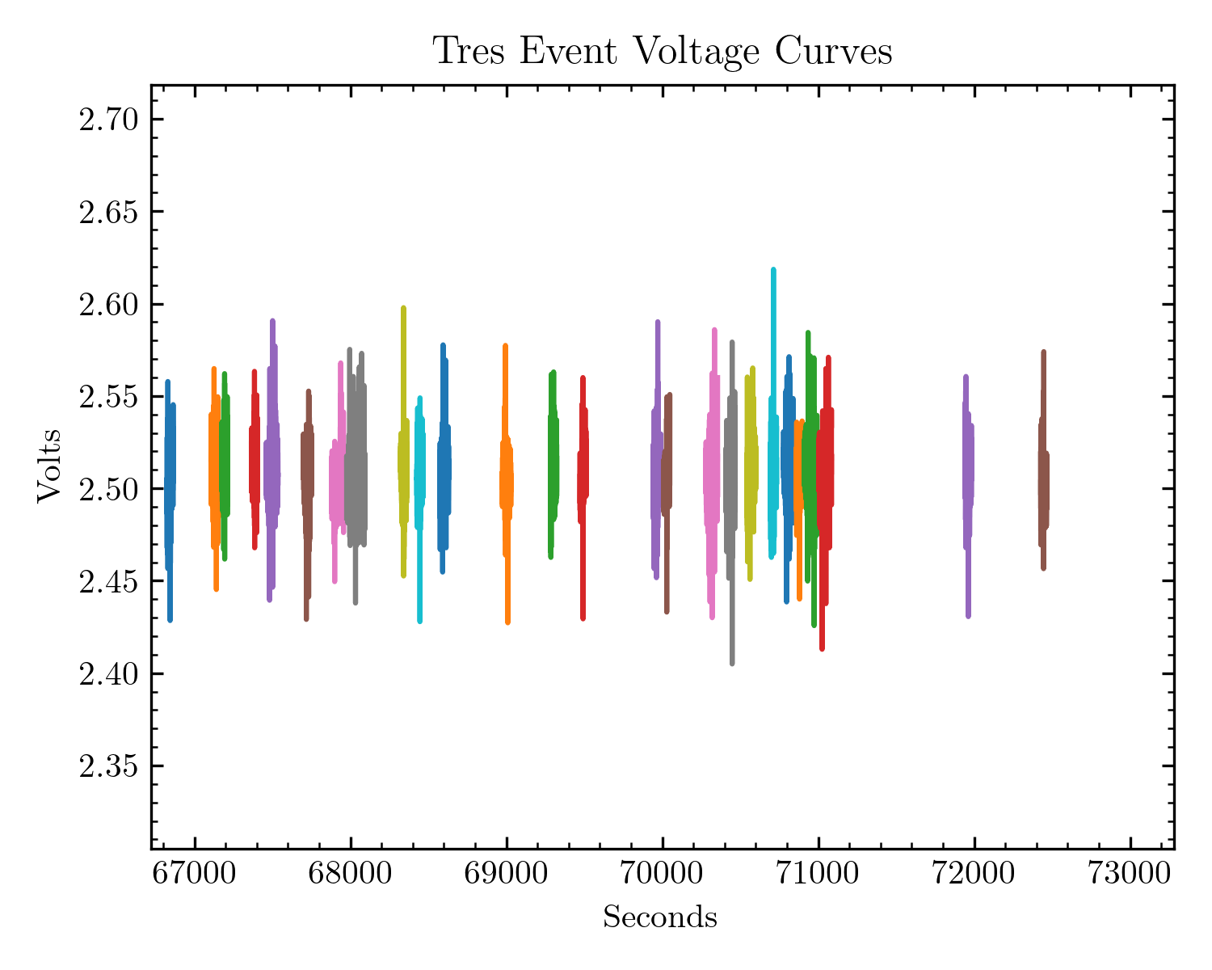
figureOut/figFixed/tresEventVolt.png
