Bkorotko03/ALTrainSeismo/figureOut/figFixed/tresNoiseVolt.png

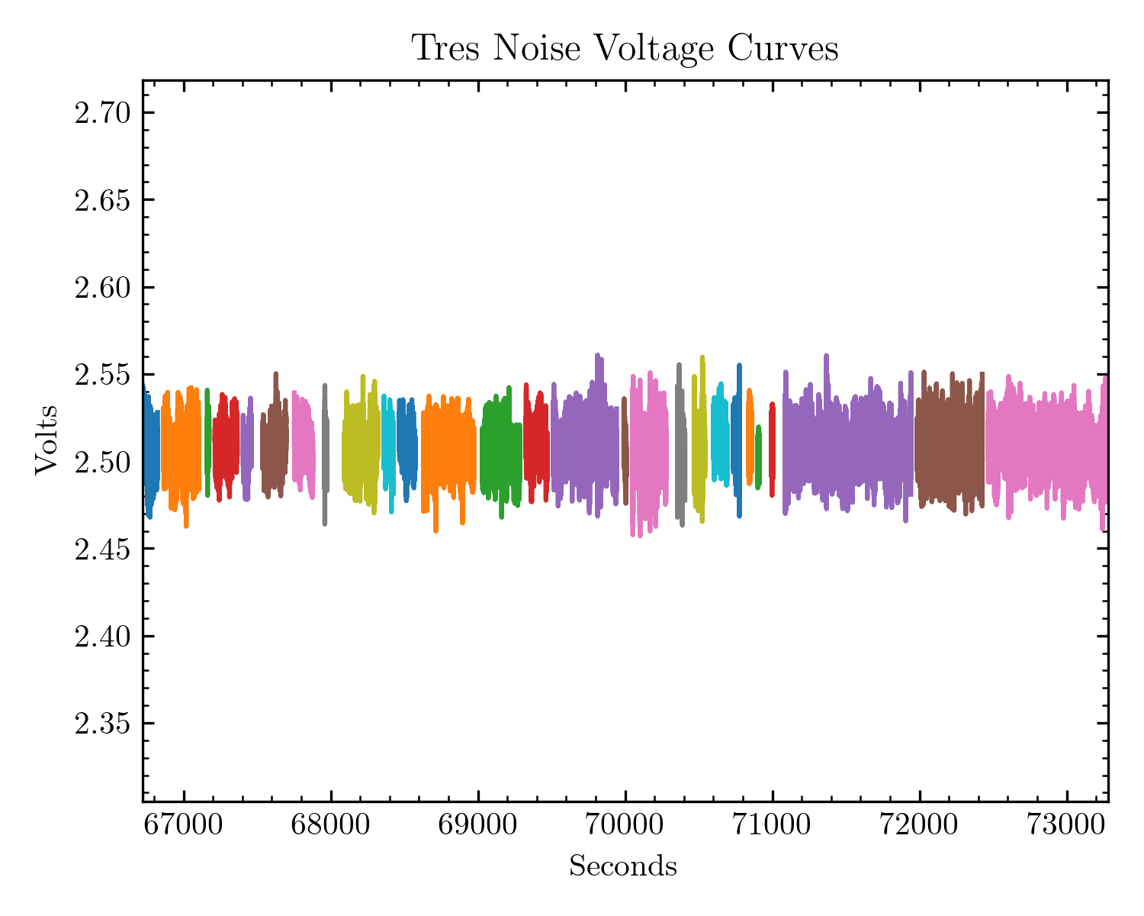
figureOut/figFixed/tresNoiseVolt.png
