Bkorotko03/ALTrainSeismo/figureOut/figFixed/unoEventVolt.png

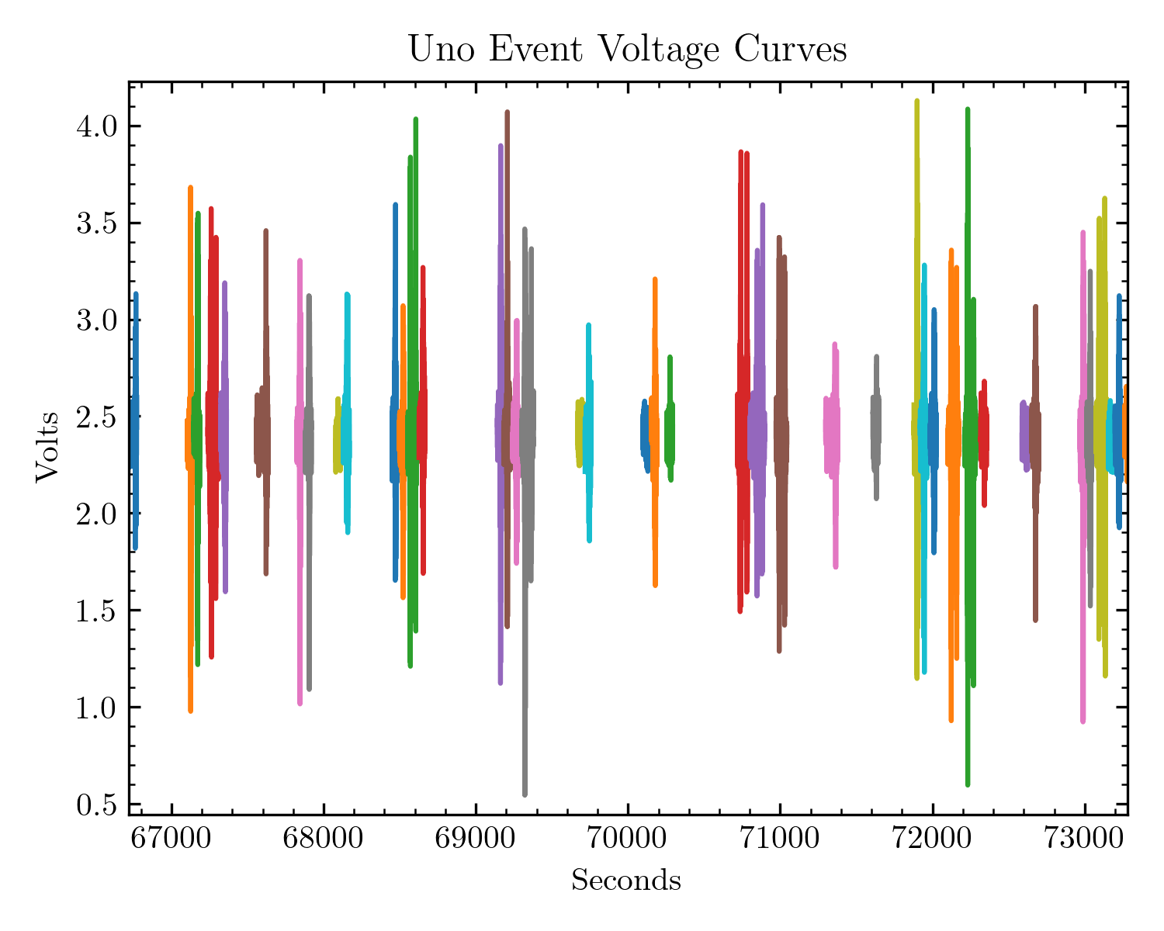
figureOut/figFixed/unoEventVolt.png
