Bkorotko03/ALTrainSeismo/figureOut/figFixed/unoNoiseVolt.png

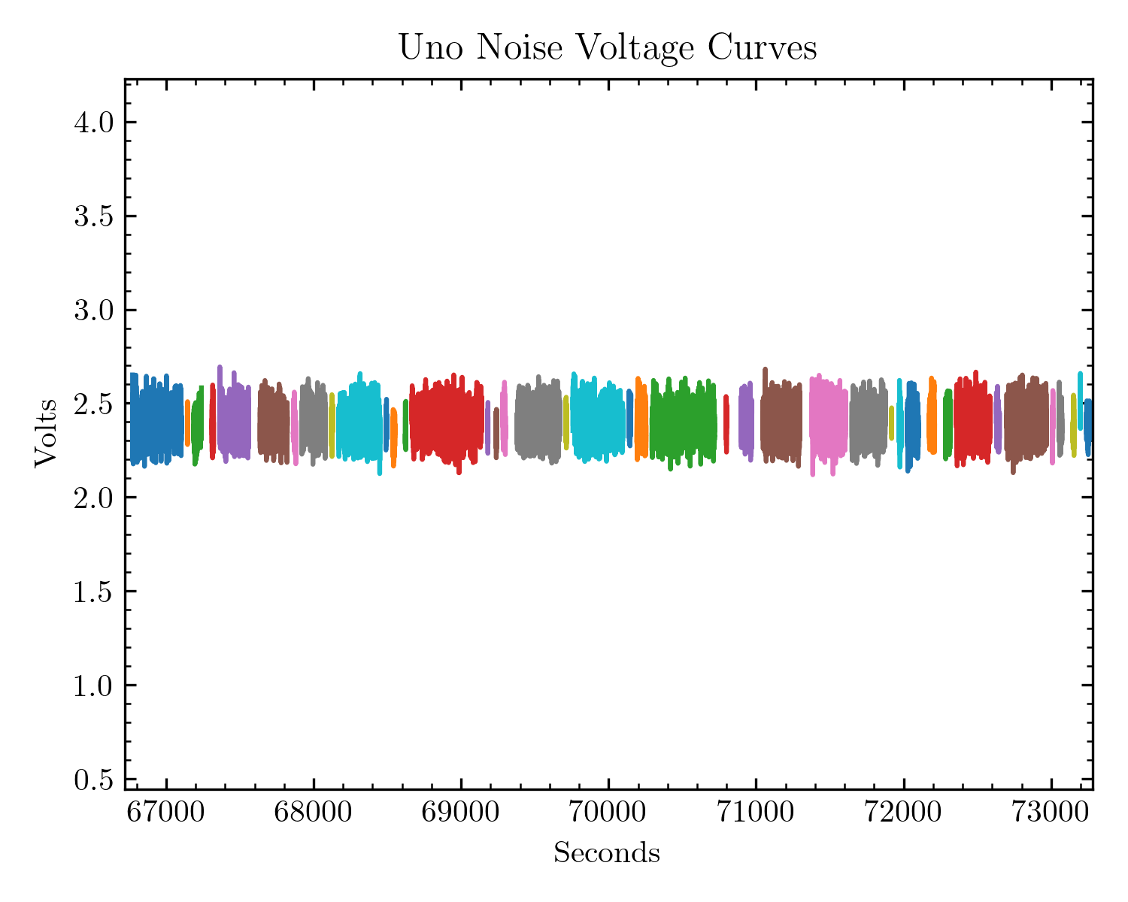
figureOut/figFixed/unoNoiseVolt.png
