Bkorotko03/ALTrainSeismo/figureOut/matchconc3win10s/avgEventPSDfs100.png

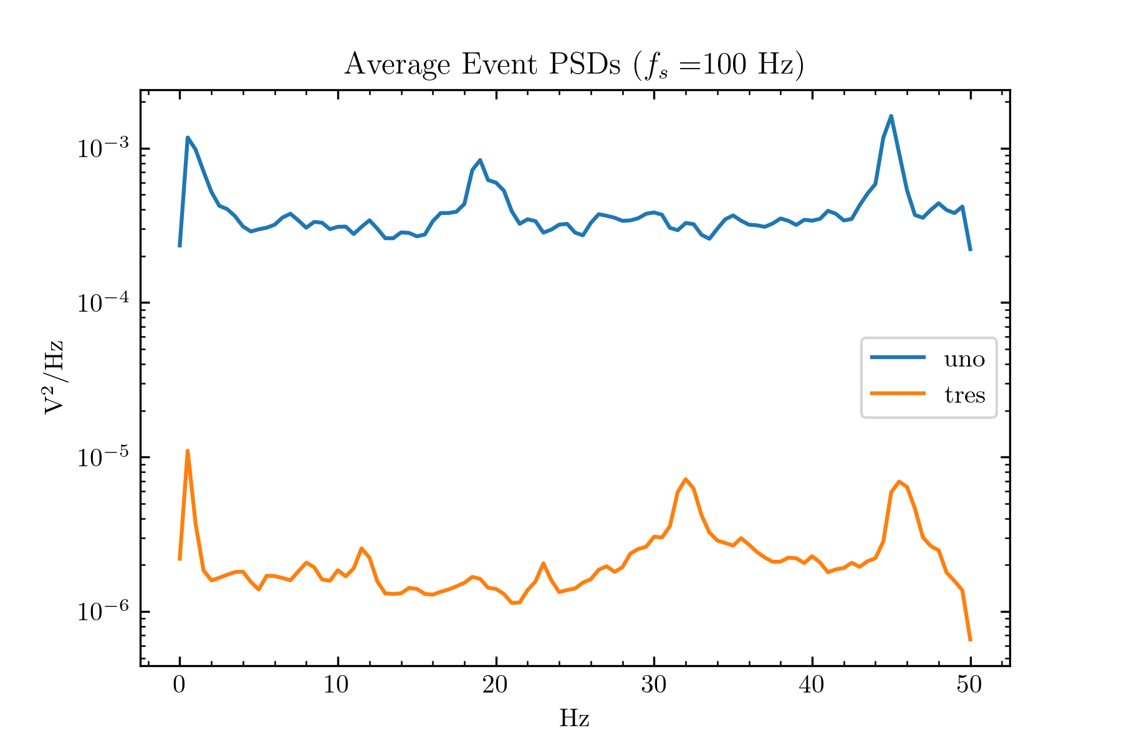
figureOut/matchconc3win10s/avgEventPSDfs100.png
