Bkorotko03/ALTrainSeismo/figureOut/matchconc3win10s/avgNoisePSDfs100.png

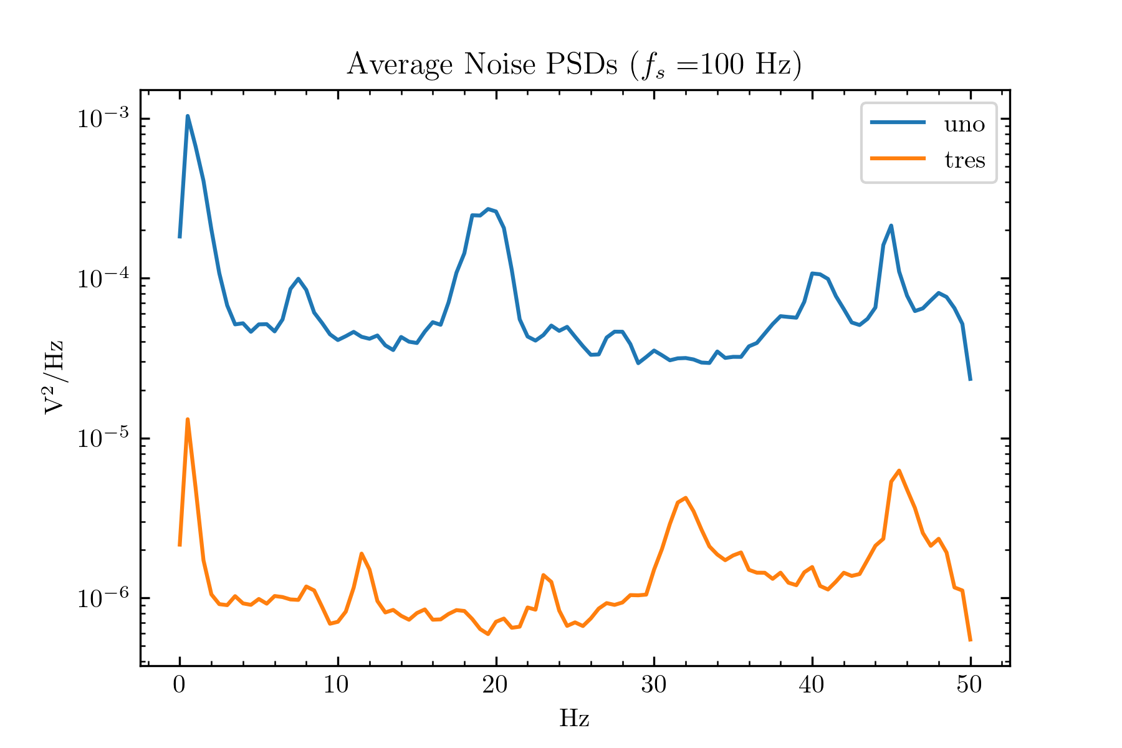
figureOut/matchconc3win10s/avgNoisePSDfs100.png
