Bkorotko03/ALTrainSeismo/figureOut/matchconc3win10s/rawSignal.png

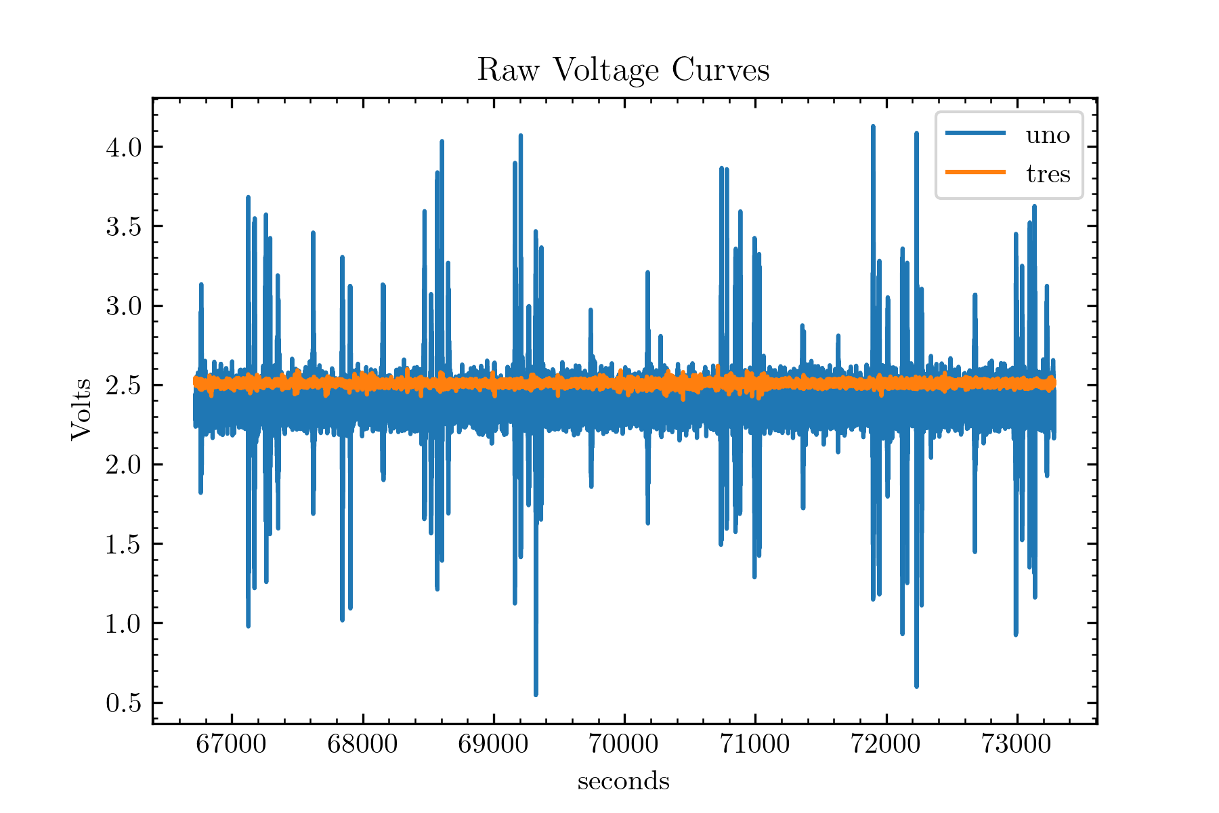
figureOut/matchconc3win10s/rawSignal.png
