Bkorotko03/ALTrainSeismo/figureOut/matchconc3win10s/SNRvsWindow.png

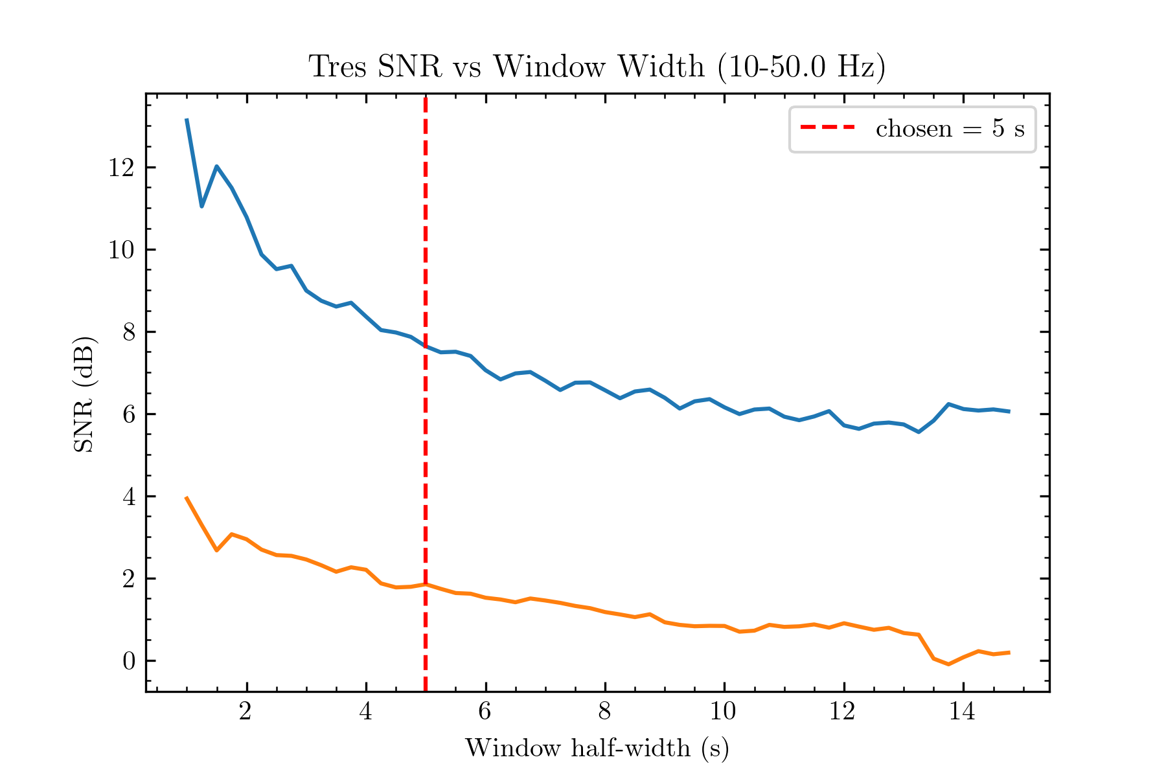
figureOut/matchconc3win10s/SNRvsWindow.png
