Bkorotko03/ALTrainSeismo/figureOut/matchconc3win10s/trainOverBkgdfs100.png

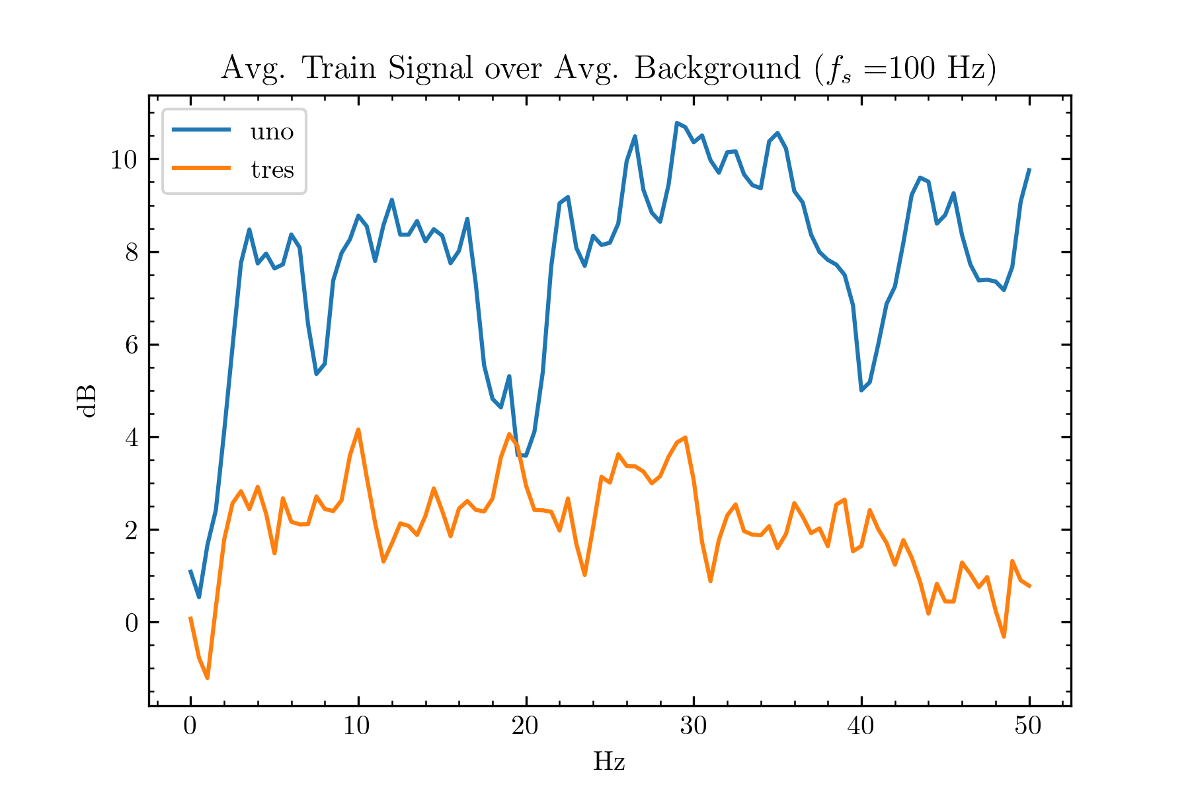
figureOut/matchconc3win10s/trainOverBkgdfs100.png
