Bkorotko03/ALTrainSeismo/figureOut/matchconc3win10s/tresEventVolt.png

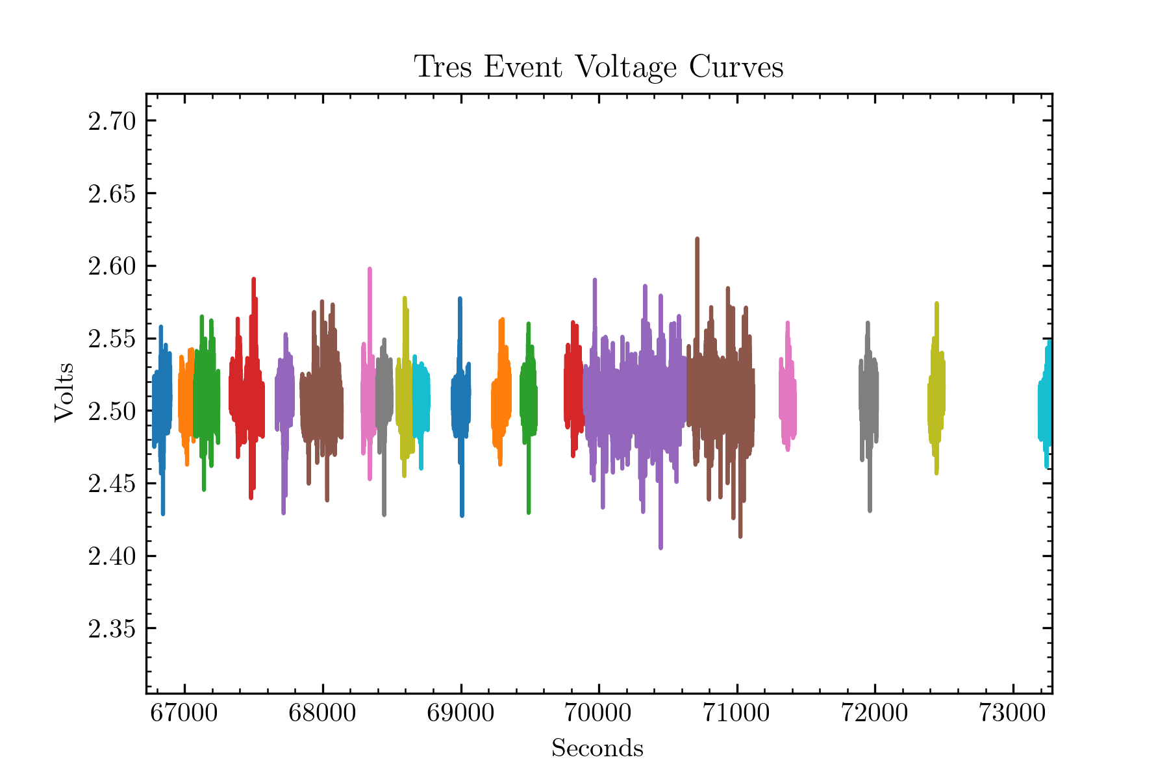
figureOut/matchconc3win10s/tresEventVolt.png
