Bkorotko03/ALTrainSeismo/figureOut/matchconc3win10s/unoNoiseVolt.png

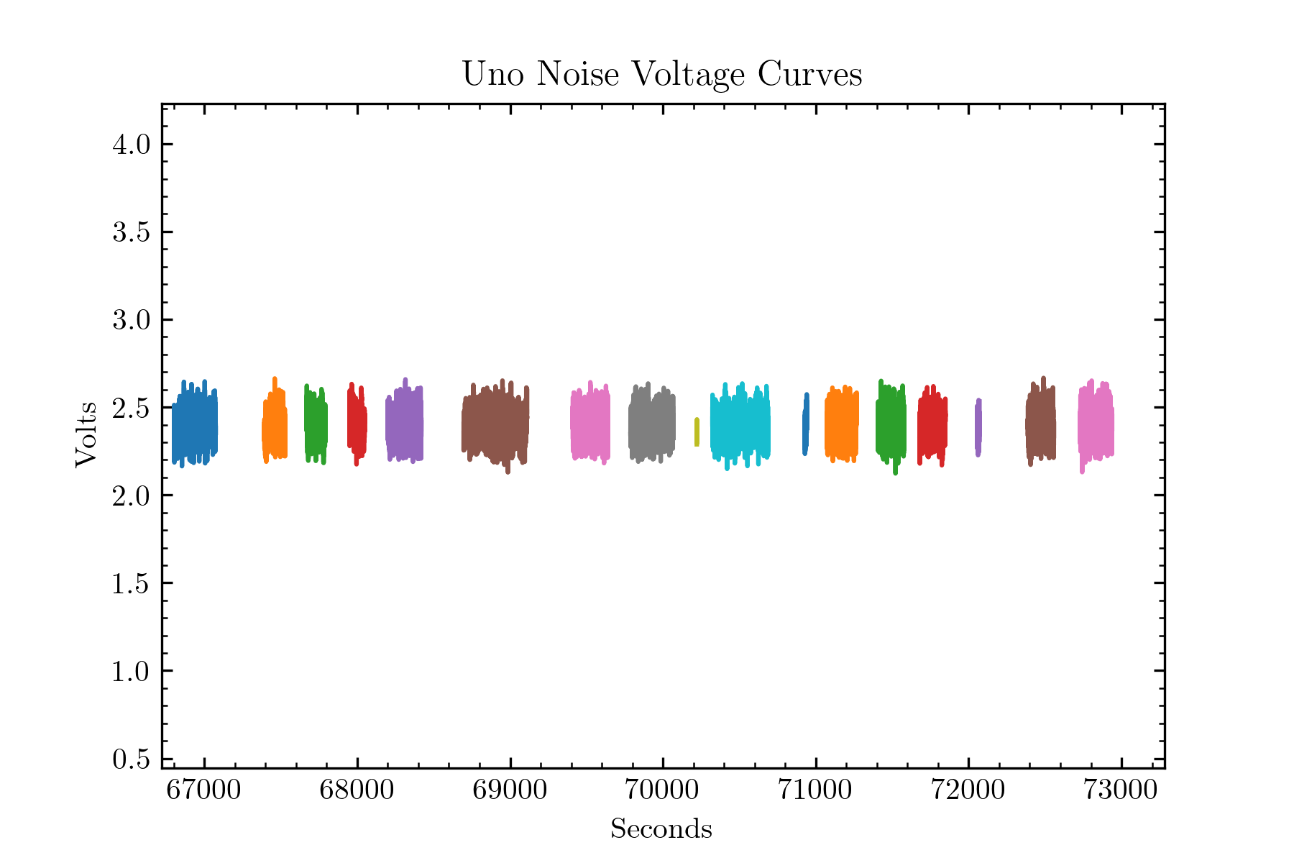
figureOut/matchconc3win10s/unoNoiseVolt.png
