Bkorotko03/ALTrainSeismo/ALProjNotes/Parts List.md

#### Definitely Required
- 3x [Adafruit Ultimate GPS Logger Shield](https://www.adafruit.com/product/1272) ($29.95 each)
- 3x [USB C Power Bank](https://www.amazon.com/Aaoyun-Portable-10000mAh-Charging-Powerbank/dp/B0DLGPX97W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) ($12.99 each)
- 3x [Adafruit External Active GPS Antenna](https://www.adafruit.com/product/960) ($21.50 each)
- 3x [SMA to uFL adapter](https://www.adafruit.com/product/851) ($3.95 each)
- 3x [Arduino Stackable Headers](https://www.digikey.com/en/products/detail/adafruit-industries-llc/85/5154649) ($1.95 each)

#### Maybe Required
-
