Bkorotko03/ALTrainSeismo/testsAndSuch/oldscripts/signaltest_references/README.txt

This directory has 2 different versions of the csvSignalTest ipynb converting csv into various arrays.

There are also several SignalTest ipynb that are just there as reference

csvSignalTestworking.ipynb is the most updated and is not in this directory
