Bkorotko03/ALTrainSeismo/testsAndSuch/oldscripts/signaltest_references/output/README.txt

This directory has examples of the output from csvSignalTest.ipynb.
