Bkorotko03/ALTrainSeismo/testsAndSuch/Csvs/magrunonpllatform26040300.csv

timecode | seconds | lat | lat_dir | lon | lon_dir | sensor
260403_001010_000 | 610.000 | 4200.0039 | N | 8739.6064 | W | 6510
260403_001010_439 | 610.439 | 4200.0039 | N | 8739.6064 | W | 6480
260403_001010_449 | 610.449 | 4200.0039 | N | 8739.6064 | W | 6434
260403_001010_459 | 610.459 | 4200.0039 | N | 8739.6064 | W | 6537
260403_001010_469 | 610.469 | 4200.0039 | N | 8739.6064 | W | 6416
260403_001010_479 | 610.479 | 4200.0039 | N | 8739.6064 | W | 6705
260403_001010_489 | 610.489 | 4200.0039 | N | 8739.6064 | W | 6545
260403_001010_499 | 610.499 | 4200.0039 | N | 8739.6064 | W | 6700
260403_001010_511 | 610.511 | 4200.0039 | N | 8739.6064 | W | 6480
260403_001010_521 | 610.521 | 4200.0039 | N | 8739.6064 | W | 6497
260403_001010_531 | 610.531 | 4200.0039 | N | 8739.6064 | W | 6523
260403_001010_541 | 610.541 | 4200.0039 | N | 8739.6064 | W | 6499
260403_001010_551 | 610.551 | 4200.0039 | N | 8739.6064 | W | 6581
260403_001010_561 | 610.561 | 4200.0039 | N | 8739.6064 | W | 6533
260403_001010_571 | 610.571 | 4200.0039 | N | 8739.6064 | W | 6474
260403_001010_581 | 610.581 | 4200.0039 | N | 8739.6064 | W | 6696
260403_001010_596 | 610.596 | 4200.0039 | N | 8739.6064 | W | 6626
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
