Bkorotko03/ALTrainSeismo/testsAndSuch/Csvs/nomag26040722.CSV

timecode | seconds | lat | lat_dir | lon | lon_dir | sensor
260407_220615_000 | 79575.000 | 4159.9824 | N | 8739.4375 | W | 514
260407_220615_430 | 79575.430 | 4159.9824 | N | 8739.4375 | W | 516
260407_220615_529 | 79575.531 | 4159.9824 | N | 8739.4375 | W | 516
260407_220615_629 | 79575.633 | 4159.9824 | N | 8739.4375 | W | 516
260407_220615_729 | 79575.727 | 4159.9824 | N | 8739.4375 | W | 516
260407_220615_829 | 79575.828 | 4159.9824 | N | 8739.4375 | W | 515
260407_220615_929 | 79575.930 | 4159.9824 | N | 8739.4375 | W | 516
260407_220616_000 | 79576.000 | 4159.9824 | N | 8739.4395 | W | 515
260407_220616_100 | 79576.102 | 4159.9824 | N | 8739.4395 | W | 515
260407_220616_200 | 79576.203 | 4159.9824 | N | 8739.4395 | W | 515
260407_220616_300 | 79576.297 | 4159.9824 | N | 8739.4395 | W | 515
260407_220616_400 | 79576.398 | 4159.9824 | N | 8739.4395 | W | 516
260407_220616_500 | 79576.500 | 4159.9824 | N | 8739.4395 | W | 515
260407_220616_600 | 79576.602 | 4159.9824 | N | 8739.4395 | W | 515
260407_220616_700 | 79576.703 | 4159.9824 | N | 8739.4395 | W | 515
260407_220616_800 | 79576.797 | 4159.9824 | N | 8739.4395 | W | 515
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
