Bkorotko03/ALTrainSeismo/testsAndSuch/Csvs/testing.csv

events | seconds
1 | 1022.45
2 | 79034.56
3 | 12234.56
4 | 18930.97
5 | 23078.12
6 | 39454.79
7 | 45456.01
8 | 49012.56
9 | 53864.97
10 | 572063.12
