Bkorotko03/ALTrainSeismo/testsAndSuch/Csvs/trashnomag26040721.CSV

timecode | seconds | lat | lat_dir | lon | lon_dir | sensor
260407_214044_000 | 78044.000 | 4159.9736 | N | 8739.4355 | W | 515
260407_214044_431 | 78044.430 | 4159.9736 | N | 8739.4355 | W | 516
260407_214044_530 | 78044.531 | 4159.9736 | N | 8739.4355 | W | 515
260407_214044_630 | 78044.633 | 4159.9736 | N | 8739.4355 | W | 515
260407_214044_730 | 78044.727 | 4159.9736 | N | 8739.4355 | W | 516
260407_214044_830 | 78044.828 | 4159.9736 | N | 8739.4355 | W | 516
260407_214044_930 | 78044.930 | 4159.9736 | N | 8739.4355 | W | 515
260407_214045_030 | 78045.031 | 4159.9736 | N | 8739.4355 | W | 515
260407_214045_130 | 78045.133 | 4159.9736 | N | 8739.4355 | W | 516
260407_214045_230 | 78045.227 | 4159.9736 | N | 8739.4355 | W | 515
260407_214045_330 | 78045.328 | 4159.9736 | N | 8739.4355 | W | 516
260407_214045_430 | 78045.430 | 4159.9736 | N | 8739.4355 | W | 516
260407_214045_530 | 78045.531 | 4159.9736 | N | 8739.4355 | W | 515
260407_214045_630 | 78045.633 | 4159.9736 | N | 8739.4355 | W | 516
260407_214045_730 | 78045.727 | 4159.9736 | N | 8739.4355 | W | 515
260407_214045_830 | 78045.828 | 4159.9736 | N | 8739.4355 | W | 515
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
