Bkorotko03/ALTrainSeismo/testsAndSuch/oldscripts/signaltest_references/output/dod/graphs/background_voltage_cut_plot.png

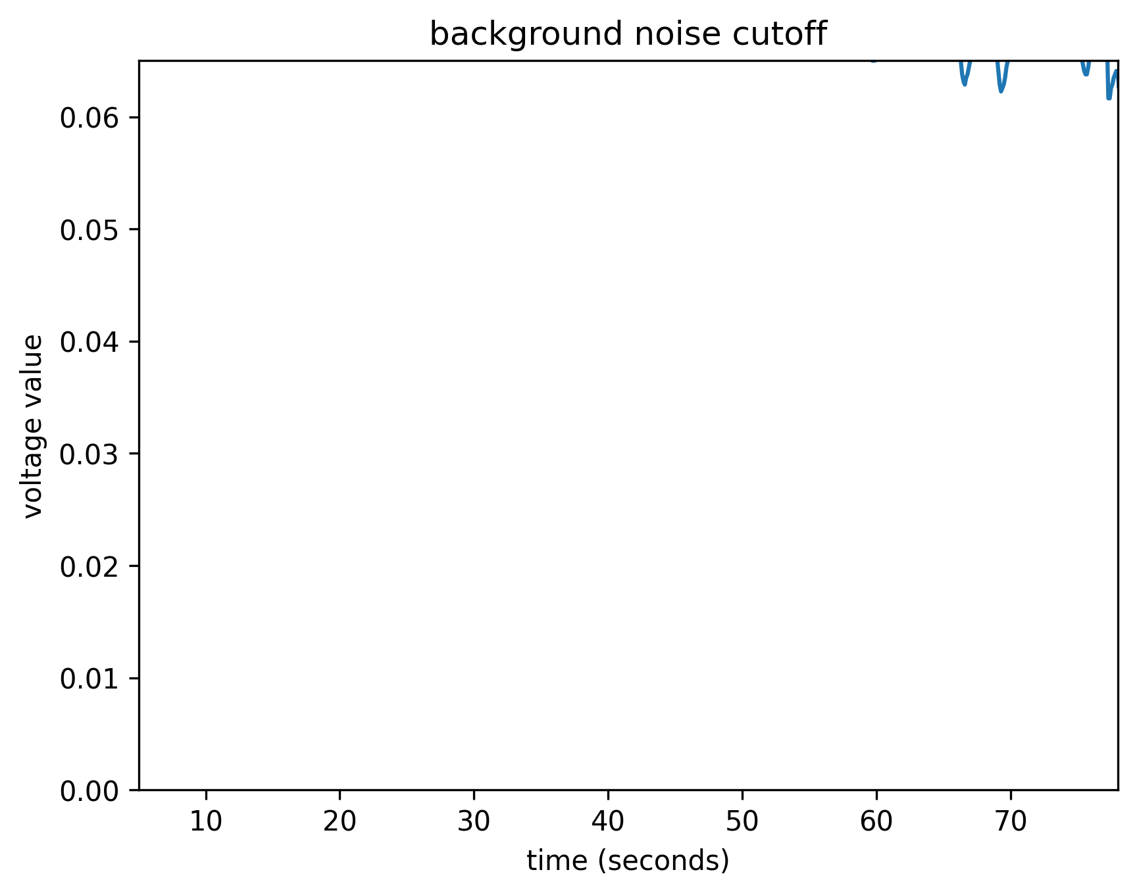
testsAndSuch/oldscripts/signaltest_references/output/dod/graphs/background_voltage_cut_plot.png
