Bkorotko03/ALTrainSeismo/testsAndSuch/oldscripts/signaltest_references/output/dod/graphs/voltage_xcut_plot.png

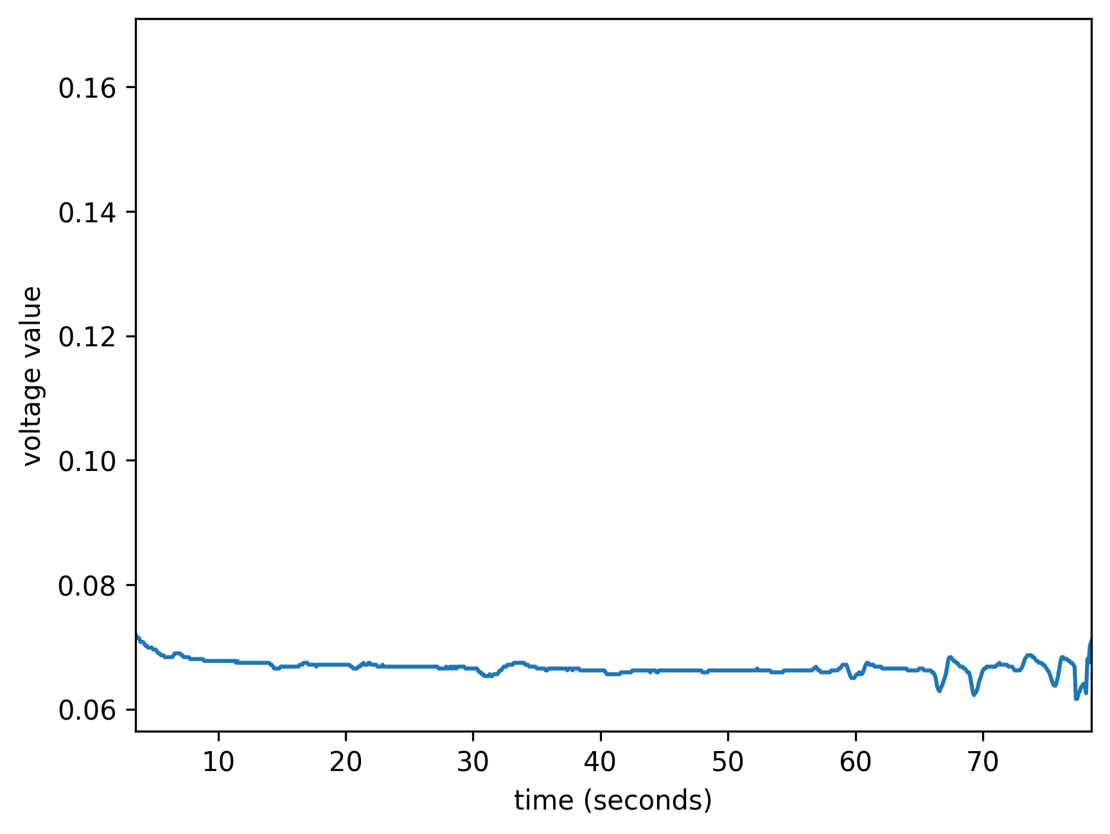
testsAndSuch/oldscripts/signaltest_references/output/dod/graphs/voltage_xcut_plot.png
