Bkorotko03/ALTrainSeismo/testsAndSuch/oldscripts/signaltest_references/signalTest_out/signal1PSD.png

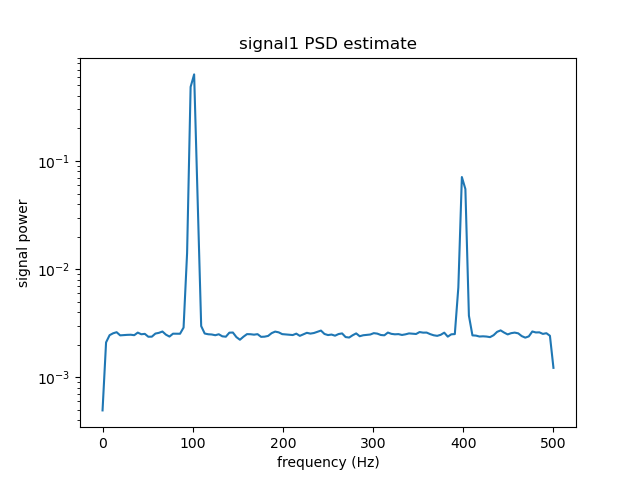
testsAndSuch/oldscripts/signaltest_references/signalTest_out/signal1PSD.png
