Bkorotko03/ALTrainSeismo/testsAndSuch/oldscripts/signaltest_references/signalTest_out/signal1wave.png

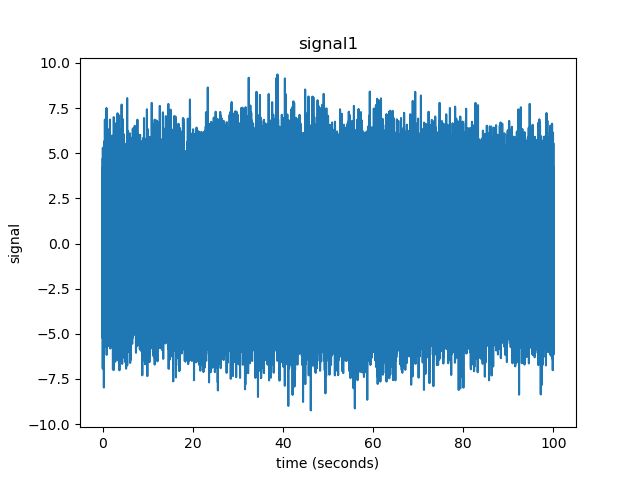
testsAndSuch/oldscripts/signaltest_references/signalTest_out/signal1wave.png
