Bkorotko03/ALTrainSeismo/testsAndSuch/output/sensor_plot.png

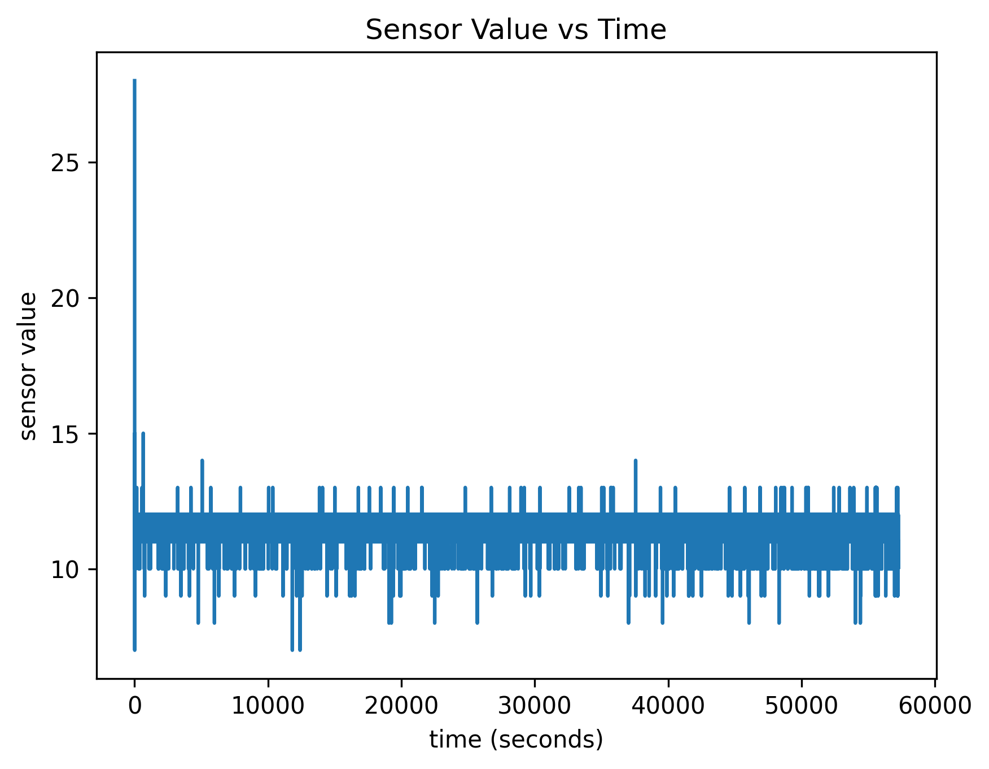
testsAndSuch/output/sensor_plot.png
