Bkorotko03/ALTrainSeismo/testsAndSuch/output/voltage_plot.png

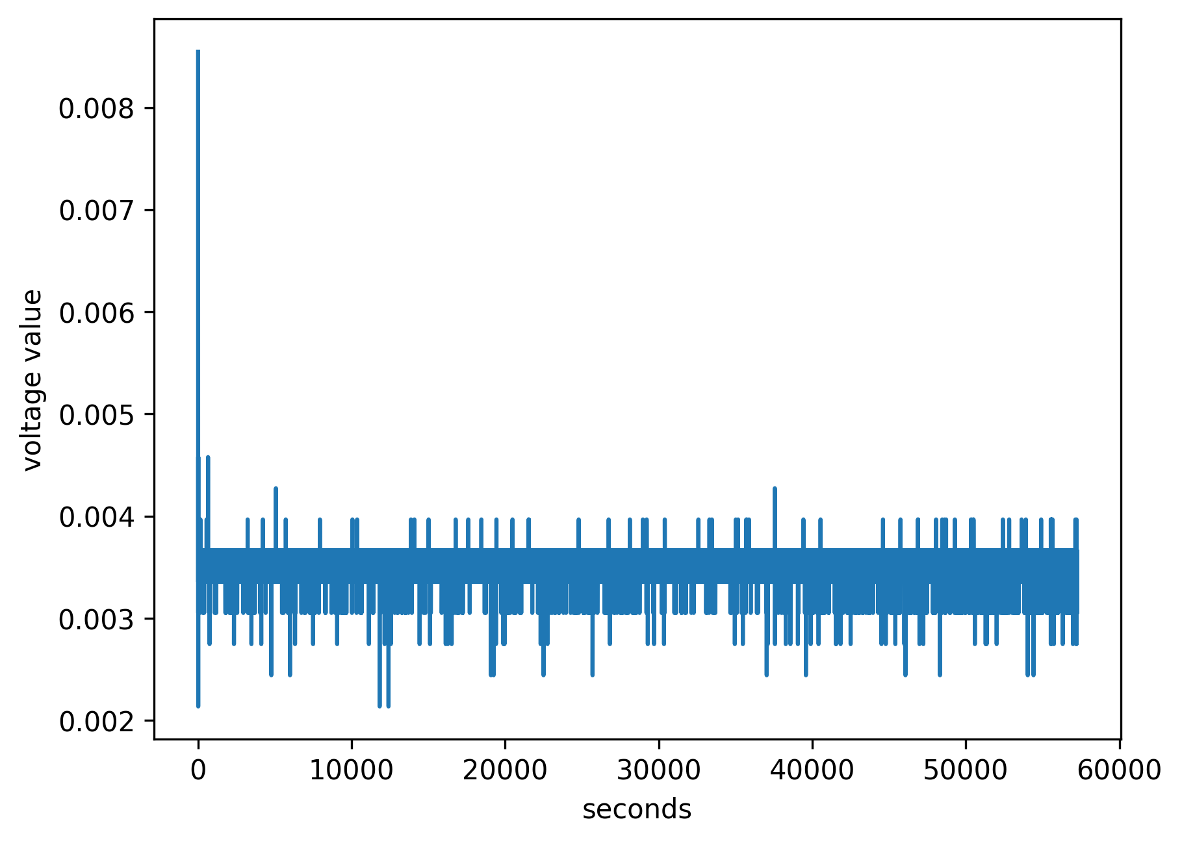
testsAndSuch/output/voltage_plot.png
