Bkorotko03/ALTrainSeismo/figureOut/debug2/SNRvsWindow.png

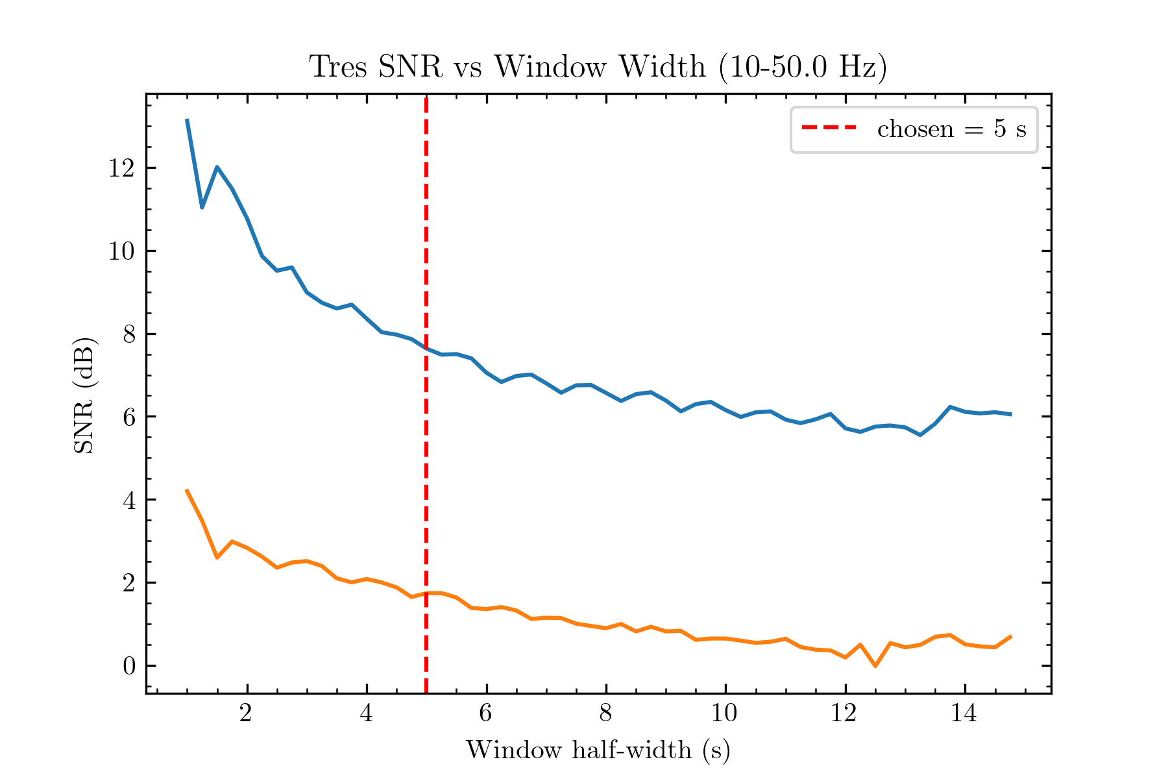
figureOut/debug2/SNRvsWindow.png
