Bkorotko03/ALTrainSeismo/figureOut/debug2/trainOverBkgdfs100.png

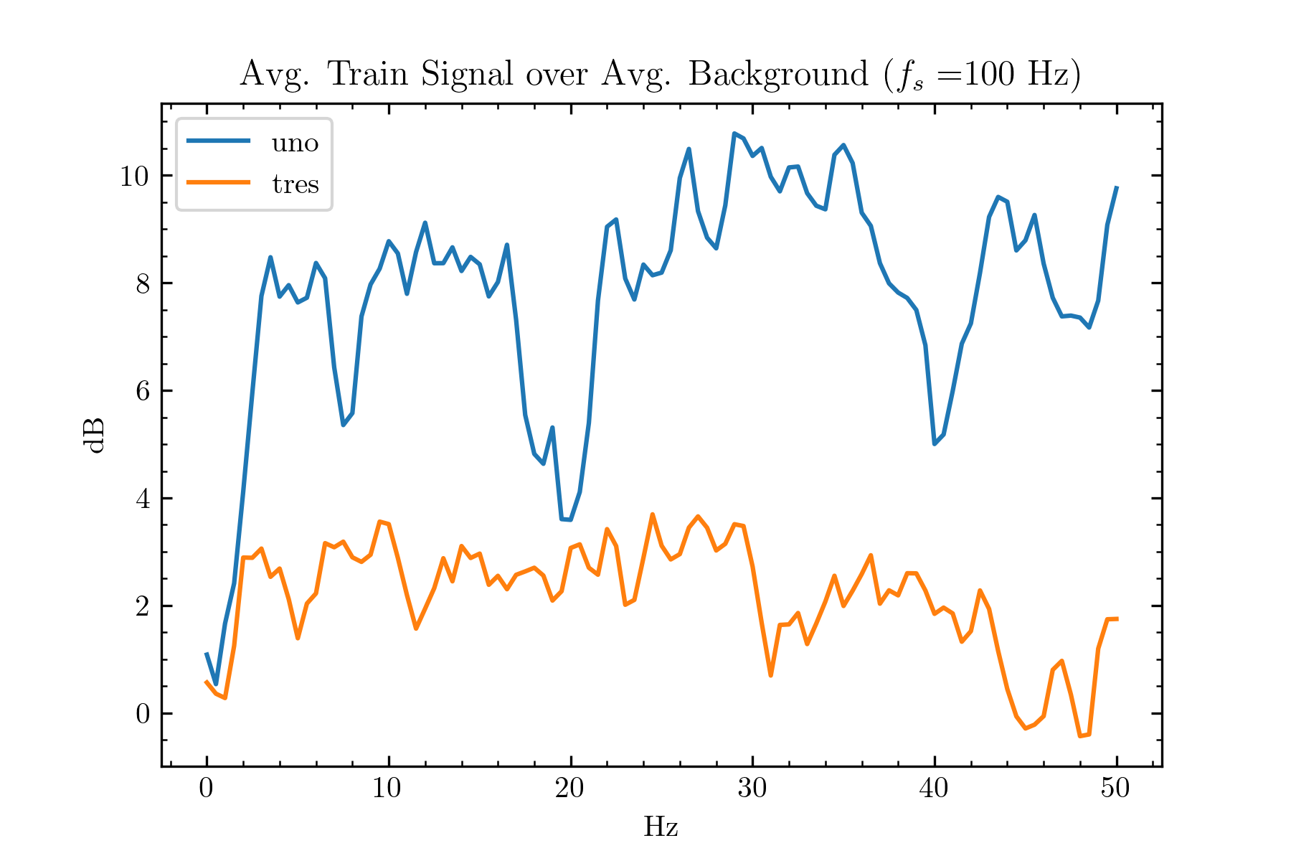
figureOut/debug2/trainOverBkgdfs100.png
