Bkorotko03/ALTrainSeismo/figureOut/debug2/tresEventVolt.png

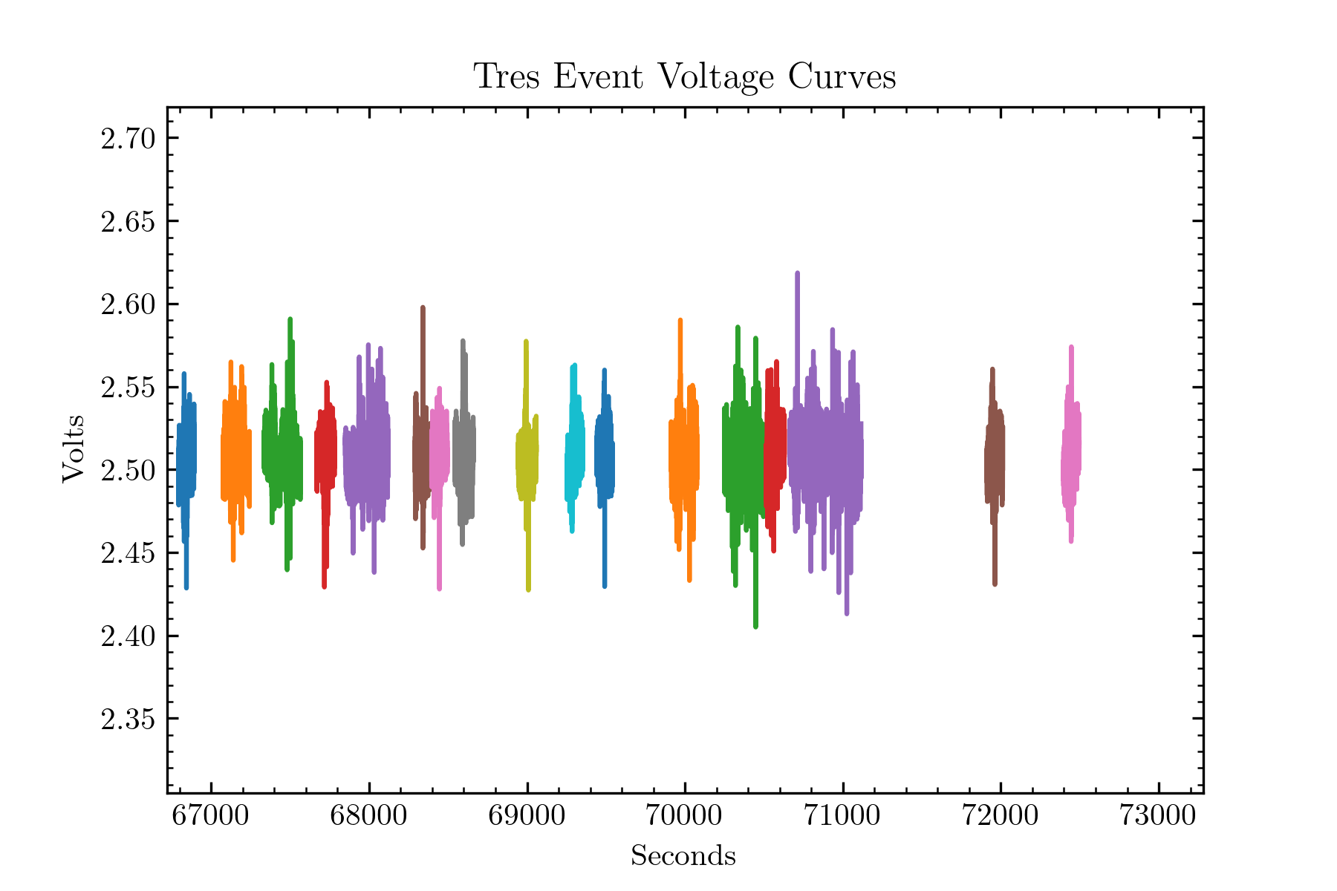
figureOut/debug2/tresEventVolt.png
