Bkorotko03/ALTrainSeismo/circuitDiagrams/AL_Amp_Circuit.pdf

# And And

↓ Gd

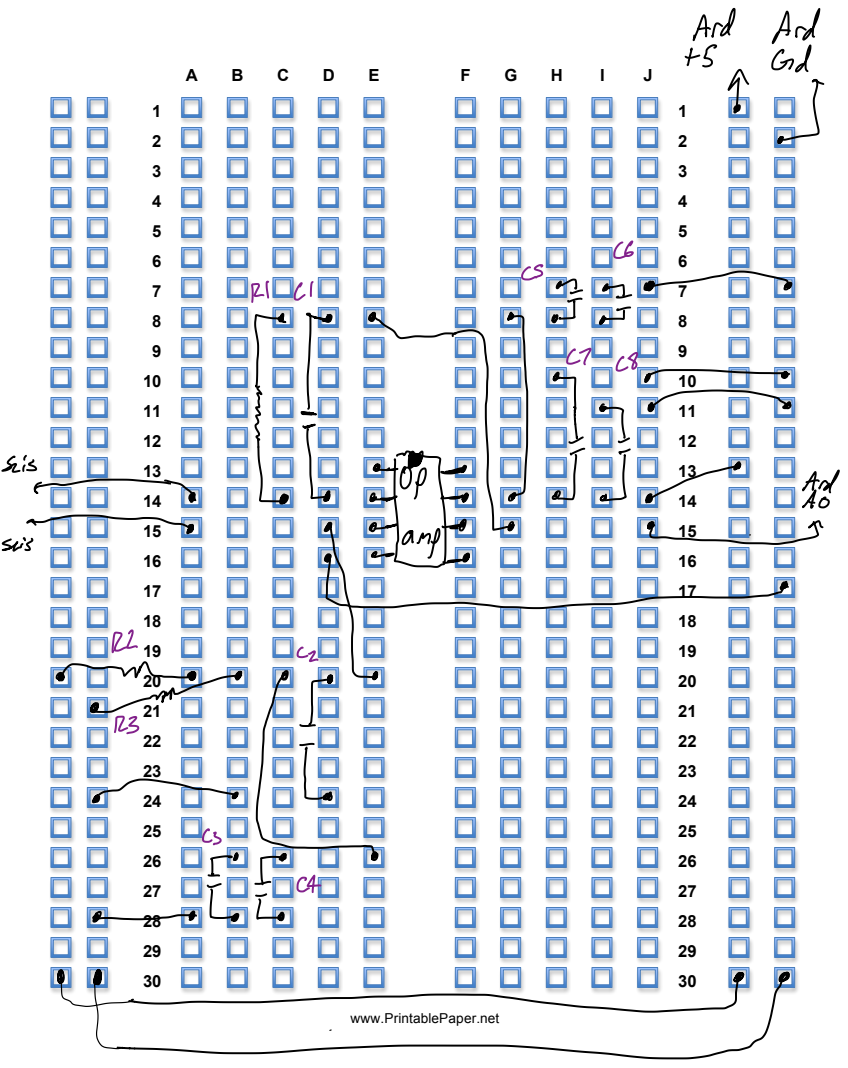
[picture p62: page 1]
Seis; seis

www.PrintablePaper.net

# eponent List

RI :9001

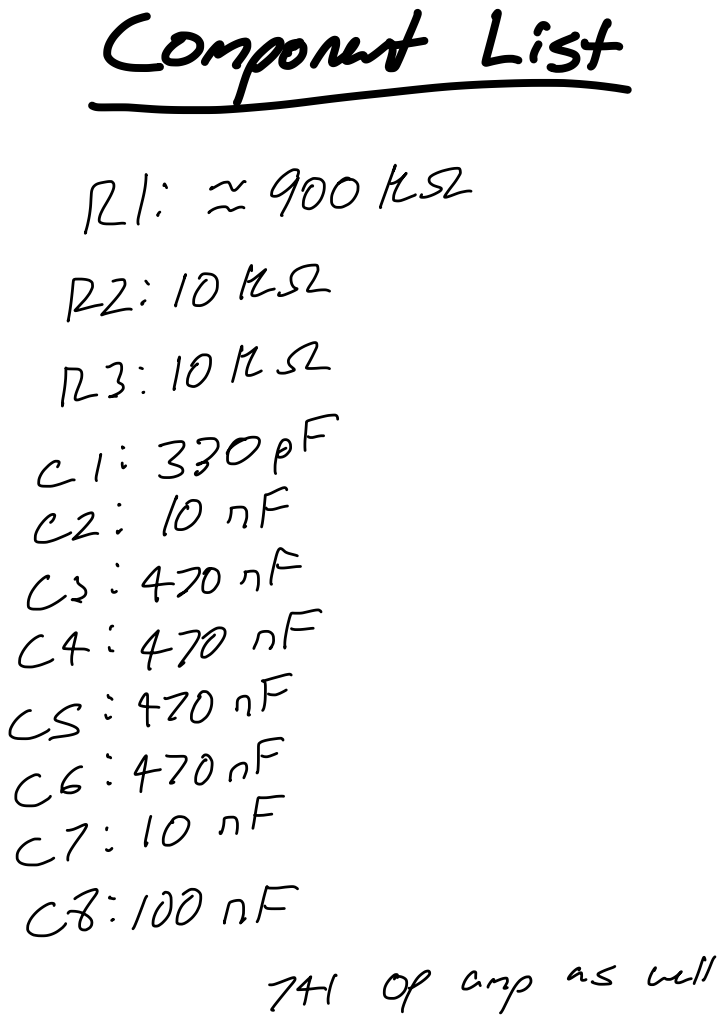
[picture p63: page 2]
Op aup; well
