Bkorotko03/ALTrainSeismo/paperThings/newAmptTest.asc.pdf

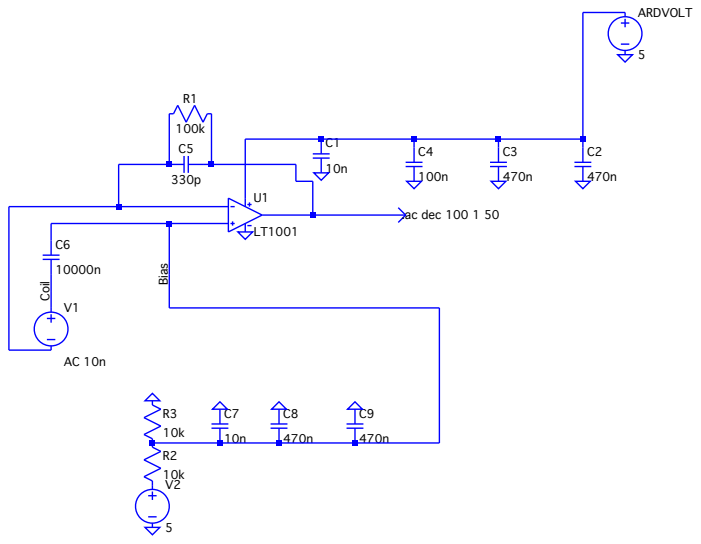
[picture p64: page 1]
