Bkorotko03/ALTrainSeismo/paperThings/newAmptTest.raw.pdf

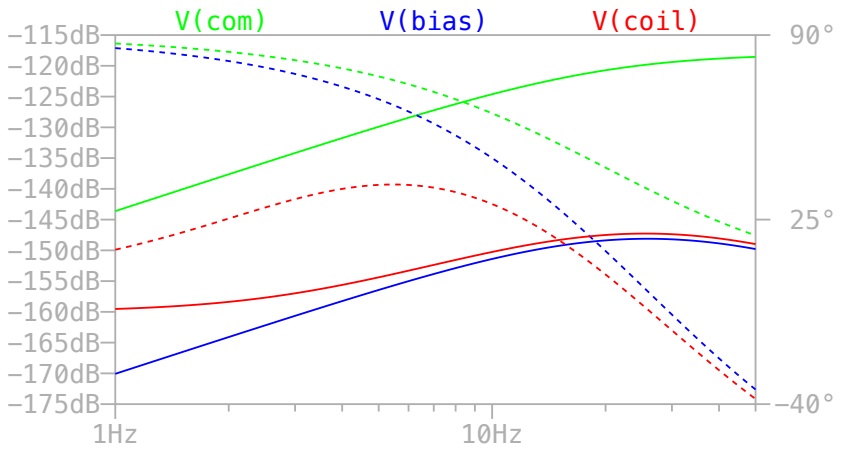
[picture p65: page 1]
