Bkorotko03/ALTrainSeismo/circuitDiagrams/newAmptTest.asc

ARDVOLT: Voltage; 5
C1: cap; 10n
C2: cap; 470n
C3: cap; 470n
C4: cap; 100n
C5: cap; 330p
C6: cap; 10000n
C7: cap; 10n
C8: cap; 470n
C9: cap; 470n
R1: res; 300k
R2: res; 10k
R3: res; 10k
U1: LT1001
V1: voltage; ""; AC 10n; Rser=800
V2: voltage; 5
Named nets: 0, COM, Coil, Bias
.ac dec 100 1 50
