Bkorotko03/ALTrainSeismo/circuitDiagrams/lab circuit.asc

C1: cap; 330F
C2: cap; 10n
C3: cap; 470n
C4: cap; 470n
C5: cap; 470n
C6: cap; 470n
C7: cap; 10n
C8: cap; 100n
R1: res; 900k
R2: res; 10k
R3: res; 10k
U1: opamp2; 741
V1: voltage; 15
V2: voltage; 15
VIN: voltage; 0; AC 1
Named nets: 0
