Bkorotko03/ALTrainSeismo/(commit log)

2026-03-24 ok so the data and gps recording works??
    [26032459.CSV, DATALOG.CSV]
2026-03-24 more printed messages
2026-03-24 test psd from csv with a few different windows
    [26032401.CSV]
2026-03-30 updated readme, updated datascript to add seconds and audio cues, and added a test CSV in /dos
    [26033020BAD.CSV]
2026-03-30 fixed an issue with elapsedSeconds not making decimal values
    [26033020.CSV]
2026-03-31 csvSignalTestcp.ipynb is the original script, csvSignalTest.ipynb is updated to put output in csvSignalTestworking.ipynb has some more automations, including creating a voltage csv file and saving ea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
2026-03-31 reorganize signaltest scripts
    [26033020.CSV, 26033020_tovoltage.csv, 26033021.CSV, 26033021_tovoltage.csv, 26033022.CSV, 26033022_tovoltage.csv, 26033023.CSV, 26033023_tovoltage.csv]
2026-04-02 i added a ipynb that looks at the csv from the arduino and cuts windows around events that we record with a clicker a.k.a it identifies times in our voltage csv that a train passed
    [identify_train_events.csv, match_report.csv, testing.csv, uno_cut.csv, voltage_after_uno.csv]
2026-04-02 upload new csv
    [26040200.CSV]
2026-04-02 ran with the capacitor fixed, results in ampnoisetest.ipynb
    [26032401.CSV, 26040200.CSV, 26040201.CSV]
2026-04-02 uhhhh the circuit is noisy as shit
2026-04-04 added csvs directory
    [26032459.CSV, 26033020.CSV, 26033020BAD.CSV, 26033020_tovoltage.csv, 26033021.CSV, 26033021_tovoltage.csv, 26033022.CSV, 26033022_tovoltage.csv]
2026-04-07 moving things, now time to start copying from csv push
    [26040201.CSV]
2026-04-07 everything is fucking broken lmao
    [identify_train_events.csv, magrunonpllatform26040300.csv, monolithTestUNO.CSV, stationTest.CSV]
2026-04-07 removing some bad data runs
    [monolithTestUNO.CSV, stationTest.CSV]
2026-04-07 huh, what???
    [noMagDOS.CSV, noMagTRES.CSV, stationTest.CSV]
2026-04-07 tres has some weird oscillation
    [noMagTRES2.CSV]
2026-04-09 nothing works not even my head
    [monolithTestDOS.CSV, monolithTestDOS2.CSV, monolithTestDOS3.CSV, monolithTestDOS4.CSV, monolithTestDOSOLD1.CSV, noMagDOS.CSV, noMagDOS2.CSV, noMagDOSOLD1.CSV]
2026-04-09 dos and tres finally have a good nomag signature, but uno is still being difficult. need to check circuit again tmrw
    [noMagFullDOS.CSV, noMagFullTRES.CSV, noMagFullUNO.CSV, noMagTRES4.CSV, noMagTRES5.CSV]
2026-04-10 ok i was able to get csvCleaner to do something with the fake clicker data, will try to get working with real and then test in combined notebook
    [clickerFAKE.csv]
2026-04-10 nomagrun stuff
    [26033020.CSV, 26033020_tovoltage.csv, 26033021.CSV, 26033021_tovoltage.csv, 26033022.CSV, 26033022_tovoltage.csv, 26033023.CSV, 26033023_tovoltage.csv]
2026-04-11 ok the amp should work now, low freq noise is inherent to lt1001 op amp. ltspice file in root. also, now all of the arduinos are reading at proper 14 bit depth (not in the psds produced so far tho), 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
    [monolithTestDOS5.CSV, newAmpTRES.CSV, noMagDOS3.CSV, noMagTRES6.CSV, noMagTRES7.CSV, noMagUNO2.CSV]
2026-04-12 working with csv cleaner
    [noMagDOS4.CSV, noMagTRES8.CSV, noMagUNO3.CSV]
2026-04-12 holy fuck we have signal
    [monolithTestDOS6.CSV, noMagDOS4.CSV]
2026-04-12 holy shit holy shit holy shit
    [concurrentTRES1.CSV, concurrentUNO1.CSV]
2026-04-13 uh so the pipe is "done" but we're not seeing ANY train signal over generic noise
    [04_12_26545-620.csv]
2026-04-13 more cleanup
    [26032459.CSV, DATALOG.CSV, clickerFAKE.csv, magrunonpllatform26040300.csv, match_report.csv, monolithTestDOS2.CSV, monolithTestDOS3.CSV, monolithTestDOS4.CSV]
2026-04-13 new circuits ahead of rebuild
2026-04-13 uhghhh why are they still inconsistent
    [newNoMagDOS.CSV, noMagFullDOS.CSV, noMagFullDOSOLD2.CSV, noMagFullTRES.CSV, noMagFullTRESOLD2.CSV, noMagFullUNO.CSV, noMagFullUNOOLD2.CSV]
2026-04-13 huh, i guess the new no mag is fine?
    [noMagFullDOS.CSV, noMagFullDOSOLD3.CSV, noMagFullTRES.CSV, noMagFullTRESOLD3.CSV, noMagFullUNO.CSV, noMagFullUNOOLD3.CSV]
2026-04-14 ran again with bigger fig sizes, need title on raw voltage
2026-04-14 raw volt title
2026-04-14 holy shit the detectors work
    [monolithTestDOS7.CSV]
2026-04-15 oh yeah concurrent run 2
    [concurrentClick2.csv, concurrentDOS2.CSV, concurrentTRES2.CSV, concurrentUNO2.CSV, noMagFullDOS.CSV, noMagFullTRES.CSV, noMagFullUNO.CSV]
2026-04-15 jesus christ why did dos have to kill itself
    [04_12_26545-620 2.csv, concurrentClick3.csv, magrunonpllatform26040300 2.csv, monolithTestDOS3 2.CSV, newNoMagDOS 2.CSV, noMagFullDOSOLD2 2.CSV, noMagFullDOSOLD3 2.CSV, noMagFullTRESOLD2 2.CSV]
